ajharvie/TeensyPolySynth/README.md

A digital polysynth based on the teensy 4.1

Code heavily adapted from  Albert Nyström's 6-voice teensy synth: https://github.com/albnys/TeensyPoly6

I'll write up the new features and improvements at some point but I promise it's dead good
