ajharvie/TeensyPolySynth/boards/TeensySynth41.kicad_pcb

## KiCad design boards/TeensySynth41.kicad_pcb (2024-10-31)

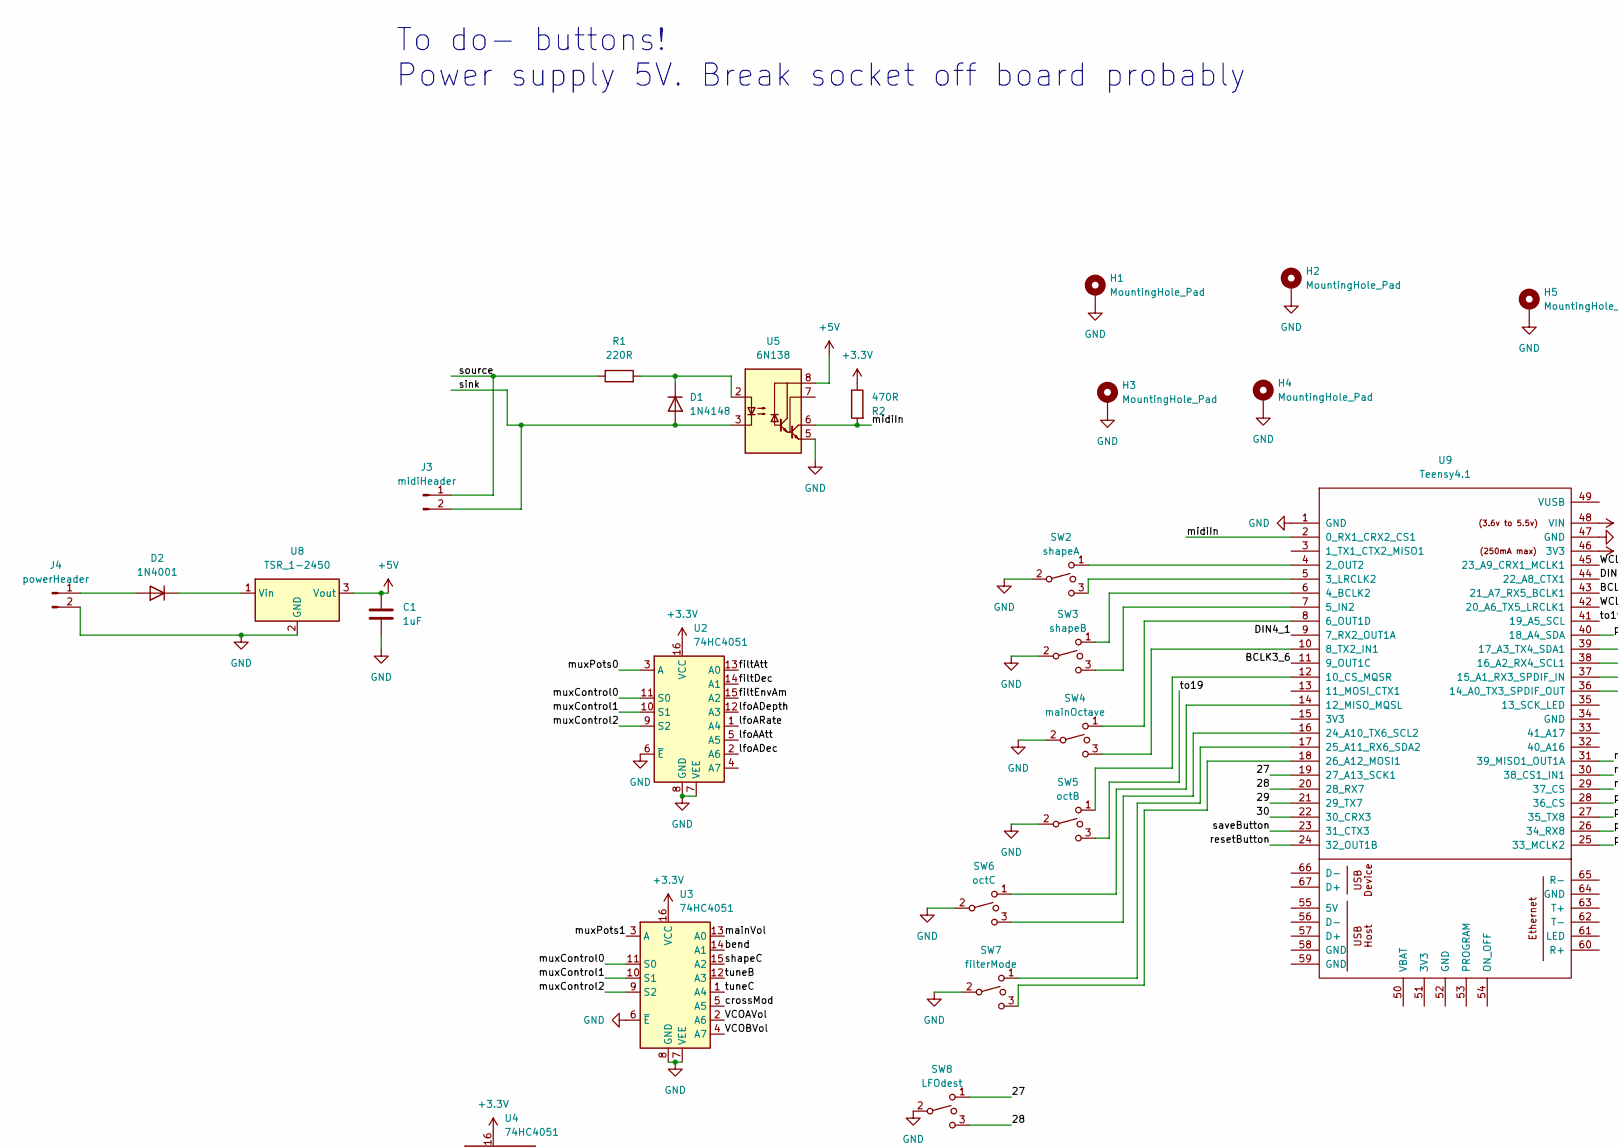
[picture p1: schematic TeensySynth41.kicad_sch, part in row 1, column 1]

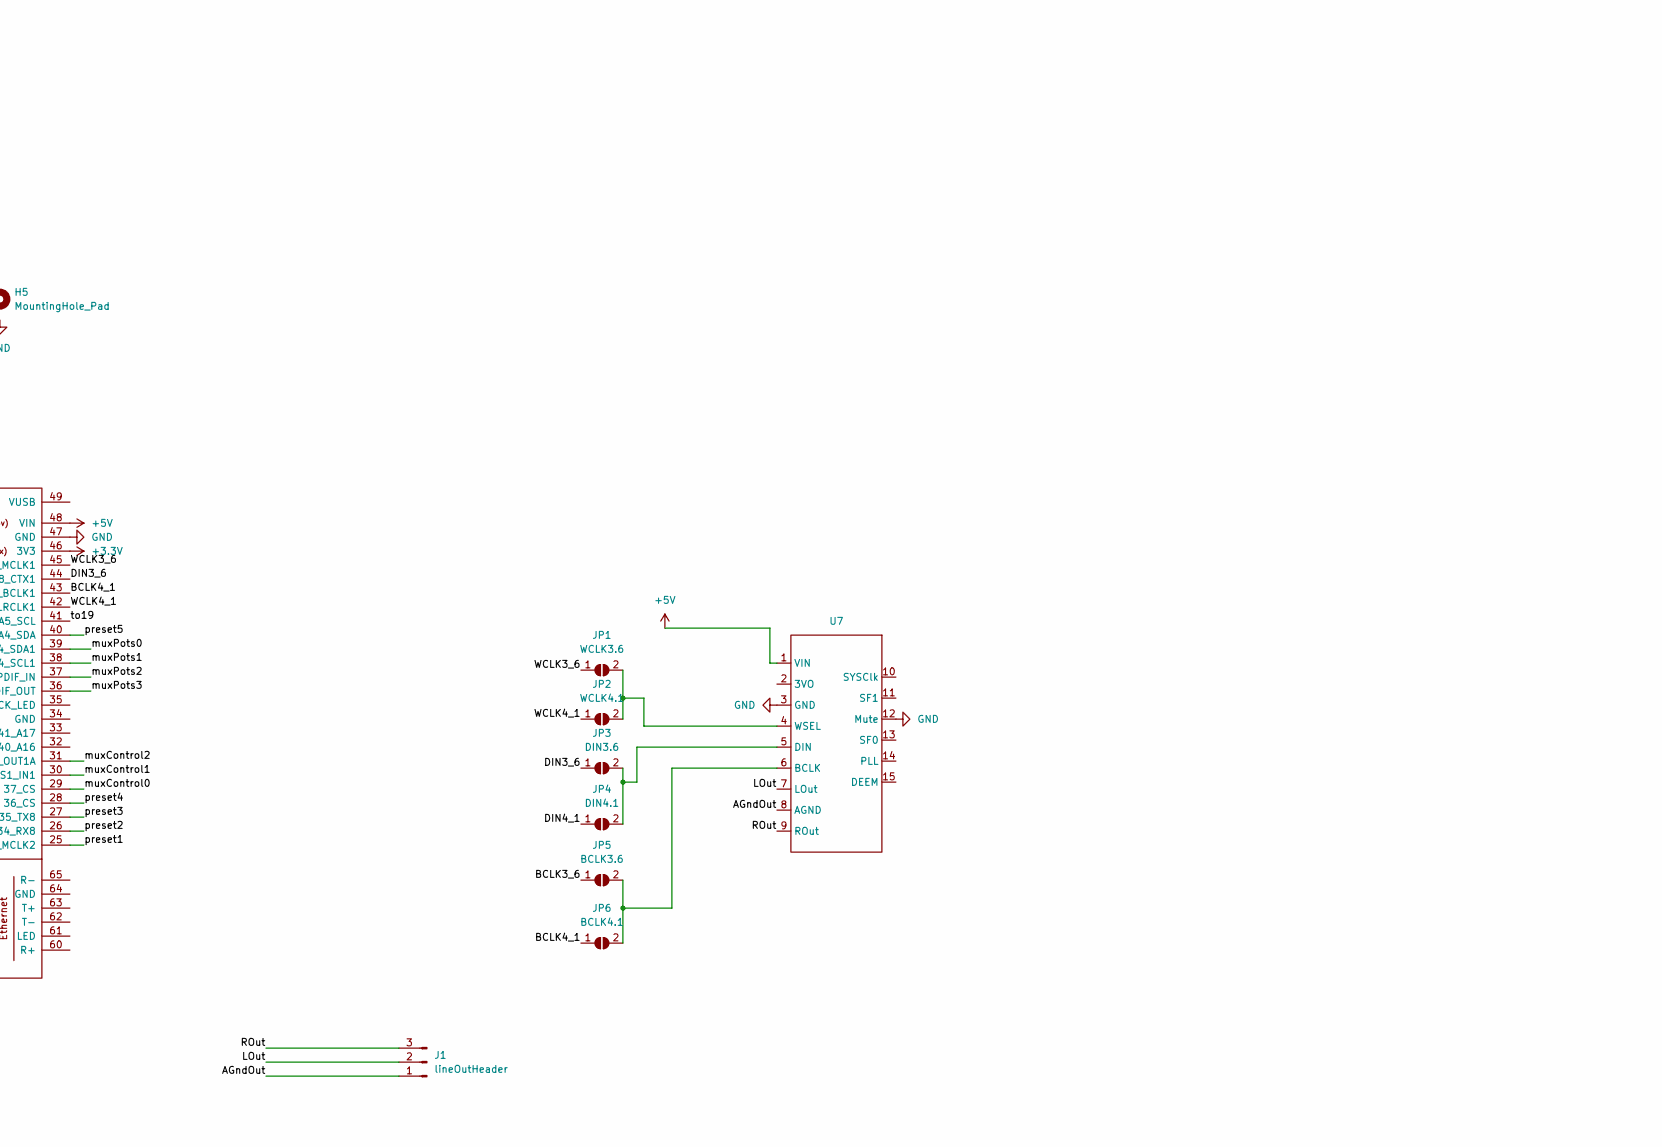
[picture p2: schematic TeensySynth41.kicad_sch, part in row 1, column 2]

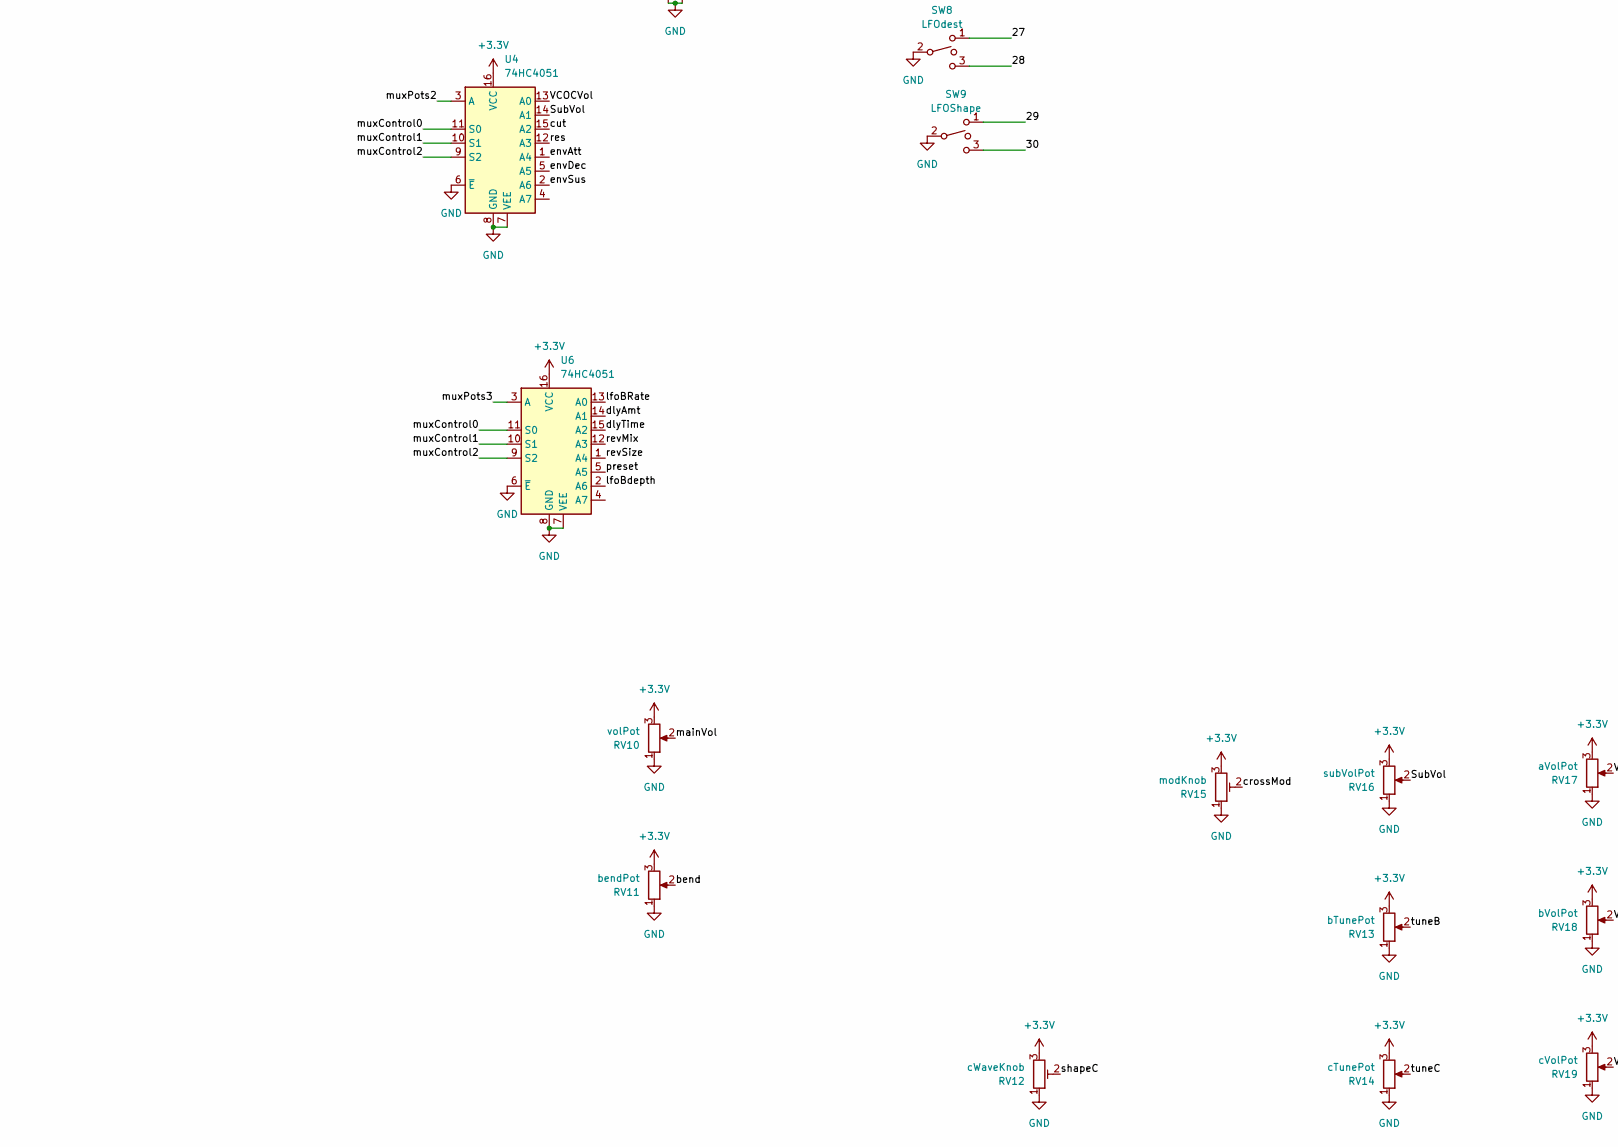
[picture p3: schematic TeensySynth41.kicad_sch, part in row 2, column 1]

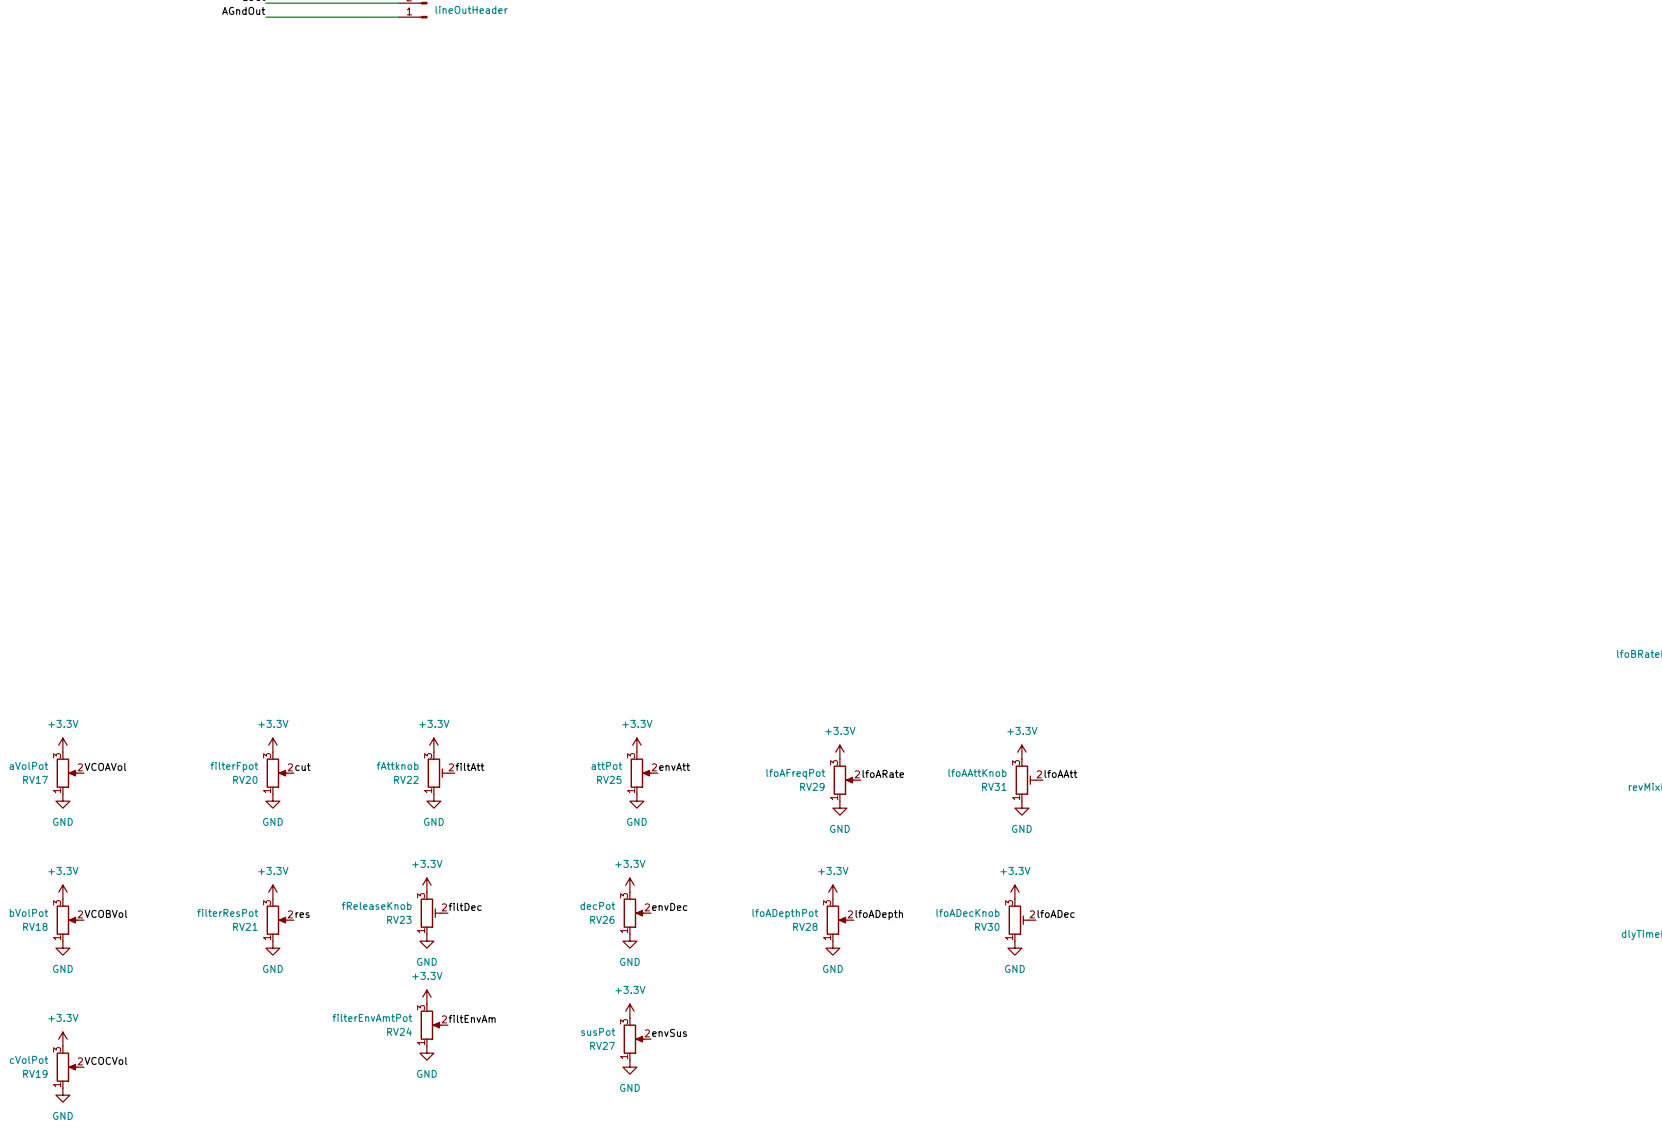
[picture p4: schematic TeensySynth41.kicad_sch, part in row 2, column 2]

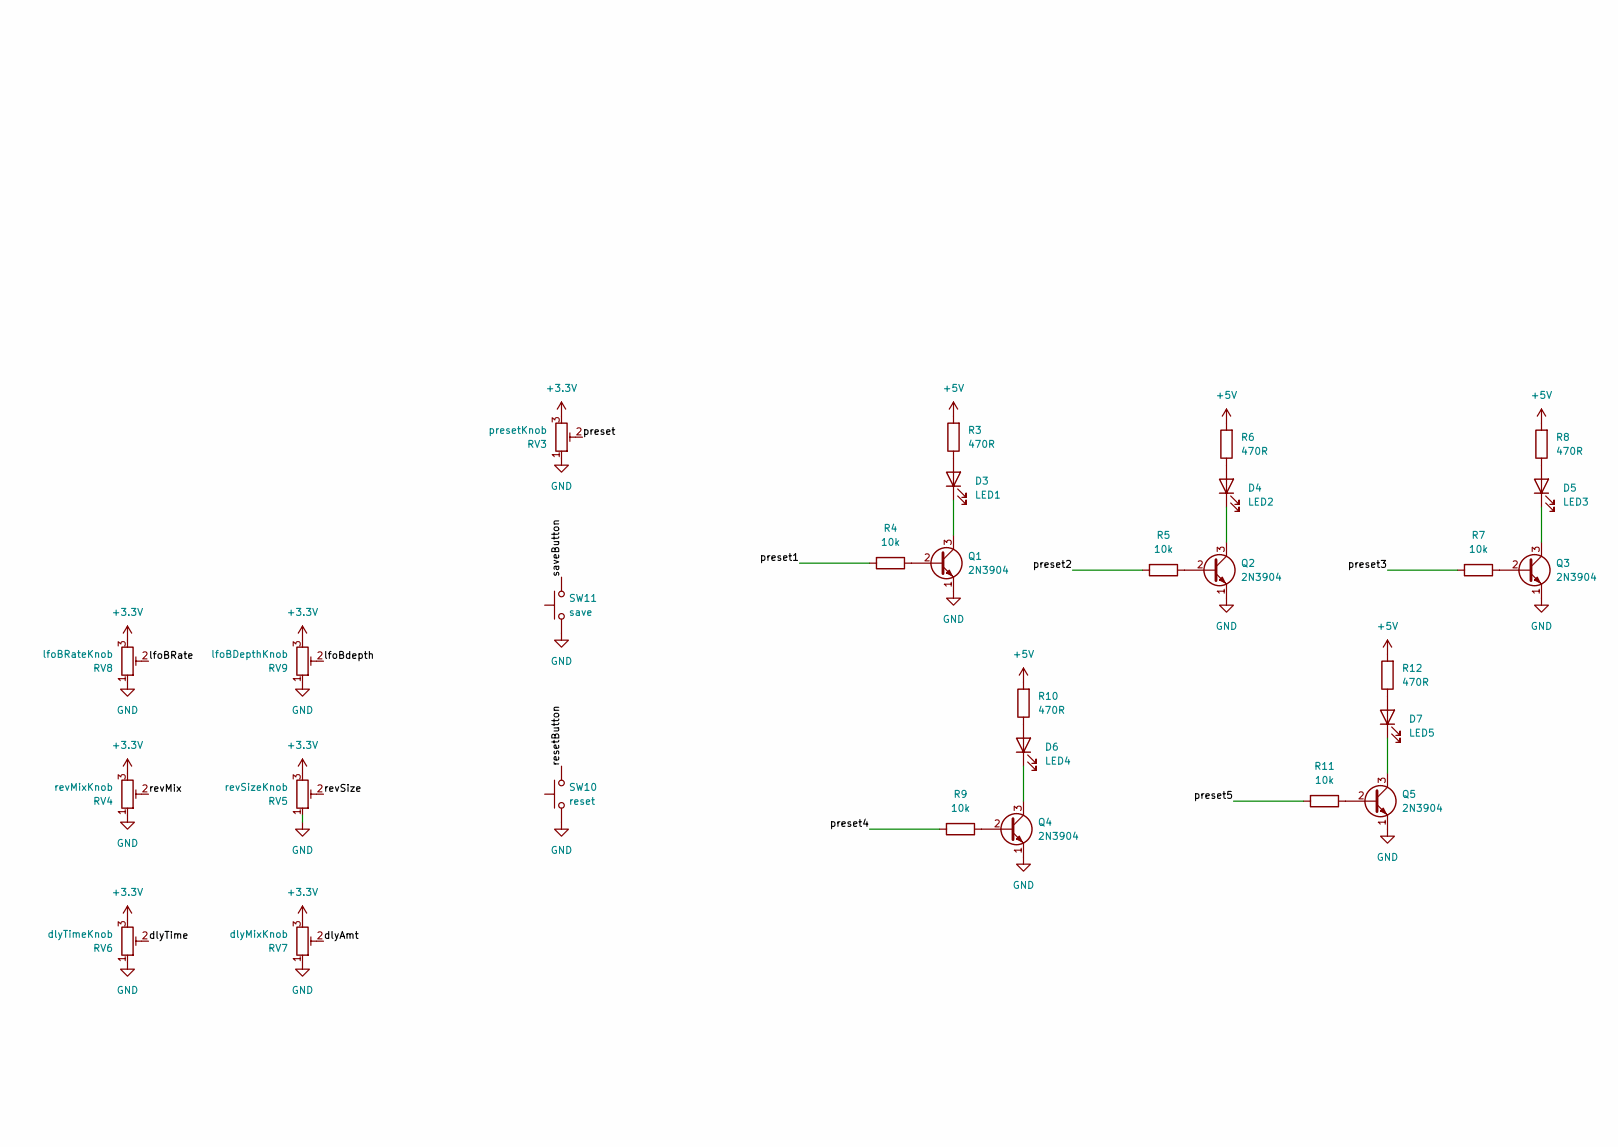
[picture p5: schematic TeensySynth41.kicad_sch, part in row 2, column 3]

Parts:
C1: 1uF; C_Disc_D7.0mm_W2.5mm_P5.00mm
D1: 1N4148; D_DO-35_SOD27_P7.62mm_Horizontal
D2: 1N4001; D_DO-41_SOD81_P10.16mm_Horizontal
D3: LED1; LED_D5.0mm_FlatTop
D4: LED2; LED_D5.0mm_FlatTop
D5: LED3; LED_D5.0mm_FlatTop
D6: LED4; LED_D5.0mm_FlatTop
D7: LED5; LED_D5.0mm_FlatTop
H1, H2, H3, H4, H5: MountingHole_Pad; MountingHole_3.2mm_M3_Pad
J1: lineOutHeader; TerminalBlock_Phoenix_MPT-0,5-3-2.54_1x03_P2.54mm_Horizontal
J3: midiHeader; TerminalBlock_Phoenix_MPT-0,5-2-2.54_1x02_P2.54mm_Horizontal
J4: powerHeader; TerminalBlock_Phoenix_MPT-0,5-2-2.54_1x02_P2.54mm_Horizontal
JP1: WCLK3.6; SolderJumper-2_P1.3mm_Open_Pad1.0x1.5mm
JP2: WCLK4.1; SolderJumper-2_P1.3mm_Open_Pad1.0x1.5mm
JP3: DIN3.6; SolderJumper-2_P1.3mm_Open_Pad1.0x1.5mm
JP4: DIN4.1; SolderJumper-2_P1.3mm_Open_Pad1.0x1.5mm
JP5: BCLK3.6; SolderJumper-2_P1.3mm_Open_Pad1.0x1.5mm
JP6: BCLK4.1; SolderJumper-2_P1.3mm_Open_Pad1.0x1.5mm
Q1, Q2, Q3, Q4, Q5: 2N3904; TO-92_Inline
R1: 220R; R_Axial_DIN0207_L6.3mm_D2.5mm_P7.62mm_Horizontal
R2, R3, R6, R8, R10, R12: 470R; R_Axial_DIN0207_L6.3mm_D2.5mm_P7.62mm_Horizontal
R4, R5, R7, R9, R11: 10k; R_Axial_DIN0207_L6.3mm_D2.5mm_P7.62mm_Horizontal
RV3: presetKnob; R0904N_newholes
RV4: revMixKnob; R0904N_newholes
RV5: revSizeKnob; R0904N_newholes
RV6: dlyTimeKnob; R0904N_newholes
RV7: dlyMixKnob; R0904N_newholes
RV8: lfoBRateKnob; R0904N_newholes
RV9: lfoBDepthKnob; R0904N_newholes
RV10: volPot; alphaPot_Centred
RV11: bendPot; alphaPot_Centred
RV12: cWaveKnob; R0904N_newholes
RV13: bTunePot; alphaPot_Centred
RV14: cTunePot; alphaPot_Centred
RV15: modKnob; R0904N_newholes
RV16: subVolPot; alphaPot_Centred
RV17: aVolPot; alphaPot_Centred
RV18: bVolPot; alphaPot_Centred
RV19: cVolPot; alphaPot_Centred
RV20: filterFpot; alphaPot_Centred
RV21: filterResPot; alphaPot_Centred
RV22: fAttknob; R0904N_newholes
RV23: fReleaseKnob; R0904N_newholes
RV24: filterEnvAmtPot; alphaPot_Centred
RV25: attPot; alphaPot_Centred
RV26: decPot; alphaPot_Centred
RV27: susPot; alphaPot_Centred
RV28: lfoADepthPot; alphaPot_Centred
RV29: lfoAFreqPot; alphaPot_Centred
RV30: lfoADecKnob; R0904N_newholes
RV31: lfoAAttKnob; R0904N_newholes
SW2: shapeA; miniToggle
SW3: shapeB; miniToggle
SW4: mainOctave; miniToggle
SW5: octB; miniToggle
SW6: octC; miniToggle
SW7: filterMode; miniToggle
SW8: LFOdest; miniToggle
SW9: LFOShape; miniToggle
SW10: reset; pushButtonEuro
SW11: save; pushButtonEuro
U2, U3, U4, U6: 74HC4051; DIP-16_W7.62mm
U5: 6N138; DIP-8_W7.62mm
U7: 1334ABreakout
U8: TSR_1-2450; Converter_DCDC_TRACO_TSR-1_THT
U9: Teensy4.1; Teensy41

Connections:
+3.3V: R2.1, RV3.3, RV4.3, RV5.3, RV6.3, RV7.3, RV8.3, RV9.3, RV10.3, RV11.3, RV12.3, RV13.3, RV14.3, RV15.3, RV16.3, RV17.3, RV18.3, RV19.3, RV20.3, RV21.3, RV22.3, RV23.3, RV24.3, RV25.3, RV26.3, RV27.3, RV28.3, RV29.3, RV30.3, RV31.3, U2.16 (VCC), U3.16 (VCC), U4.16 (VCC), U6.16 (VCC), U9.46 (3V3)
+5V: C1.1, R3.2, R6.2, R8.2, R10.2, R12.2, U5.8 (VCC), U7.1 (VIN), U8.3 (Vout), U9.48 (VIN)
/27: SW8.1, U9.19 (27_A13_SCK1)
/28: SW8.3, U9.20 (28_RX7)
/29: SW9.1, U9.21 (29_TX7)
/30: SW9.3, U9.22 (30_CRX3)
/AGndOut: J1.1, U7.8 (AGND)
/BCLK3_6: JP5.1 (A), U9.11 (9_OUT1C)
/BCLK4_1: JP6.1 (A), U9.43 (21_A7_RX5_BCLK1)
/DIN3_6: JP3.1 (A), U9.44 (22_A8_CTX1)
/DIN4_1: JP4.1 (A), U9.9 (7_RX2_OUT1A)
/LOut: J1.2, U7.7 (LOut)
/ROut: J1.3, U7.9 (ROut)
/SubVol: RV16.2, U4.14 (A1)
/VCOAVol: RV17.2, U3.2 (A6)
/VCOBVol: RV18.2, U3.4 (A7)
/VCOCVol: RV19.2, U4.13 (A0)
/WCLK3_6: JP1.1 (A), U9.45 (23_A9_CRX1_MCLK1)
/WCLK4_1: JP2.1 (A), U9.42 (20_A6_TX5_LRCLK1)
/bend: RV11.2, U3.14 (A1)
/crossMod: RV15.2, U3.5 (A5)
/cut: RV20.2, U4.15 (A2)
/dlyAmt: RV7.2, U6.14 (A1)
/dlyTime: RV6.2, U6.15 (A2)
/envAtt: RV25.2, U4.1 (A4)
/envDec: RV26.2, U4.5 (A5)
/envSus: RV27.2, U4.2 (A6)
/filtAtt: RV22.2, U2.13 (A0)
/filtDec: RV23.2, U2.14 (A1)
/filtEnvAm: RV24.2, U2.15 (A2)
/lfoAAtt: RV31.2, U2.5 (A5)
/lfoADec: RV30.2, U2.2 (A6)
/lfoADepth: RV28.2, U2.12 (A3)
/lfoARate: RV29.2, U2.1 (A4)
/lfoBRate: RV8.2, U6.13 (A0)
/lfoBdepth: RV9.2, U6.2 (A6)
/mainVol: RV10.2, U3.13 (A0)
/midiIn: R2.2, U5.6 (VO2), U9.2 (0_RX1_CRX2_CS1)
/muxControl0: U2.11 (S0), U3.11 (S0), U4.11 (S0), U6.11 (S0), U9.29 (37_CS)
/muxControl1: U2.10 (S1), U3.10 (S1), U4.10 (S1), U6.10 (S1), U9.30 (38_CS1_IN1)
/muxControl2: U2.9 (S2), U3.9 (S2), U4.9 (S2), U6.9 (S2), U9.31 (39_MISO1_OUT1A)
/muxPots0: U2.3 (A), U9.39 (17_A3_TX4_SDA1)
/muxPots1: U3.3 (A), U9.38 (16_A2_RX4_SCL1)
/muxPots2: U4.3 (A), U9.37 (15_A1_RX3_SPDIF_IN)
/muxPots3: U6.3 (A), U9.36 (14_A0_TX3_SPDIF_OUT)
/preset: RV3.2, U6.5 (A5)
/preset1: R4.2, U9.25 (33_MCLK2)
/preset2: R5.2, U9.26 (34_RX8)
/preset3: R7.2, U9.27 (35_TX8)
/preset4: R9.2, U9.28 (36_CS)
/preset5: R11.2, U9.40 (18_A4_SDA)
/res: RV21.2, U4.12 (A3)
/resetButton: SW10.2, U9.24 (32_OUT1B)
/revMix: RV4.2, U6.12 (A3)
/revSize: RV5.2, U6.1 (A4)
/saveButton: SW11.2, U9.23 (31_CTX3)
/shapeC: RV12.2, U3.15 (A2)
/sink: D1.2 (A), J3.2, U5.3 (C2)
/source: J3.1, R1.1
/to19: SW5.3, U9.41 (19_A5_SCL)
/tuneB: RV13.2, U3.12 (A3)
/tuneC: RV14.2, U3.1 (A4)
GND: C1.2, H1.1, H2.1, H3.1, H4.1, H5.1, J4.2, Q1.1 (E), Q2.1 (E), Q3.1 (E), Q4.1 (E), Q5.1 (E), RV3.1, RV4.1, RV5.1, RV6.1, RV7.1, RV8.1, RV9.1, RV10.1, RV11.1, RV12.1, RV13.1, RV14.1, RV15.1, RV16.1, RV17.1, RV18.1, RV19.1, RV20.1, RV21.1, RV22.1, RV23.1, RV24.1, RV25.1, RV26.1, RV27.1, RV28.1, RV29.1, RV30.1, RV31.1, SW2.2, SW3.2, SW4.2, SW5.2, SW6.2, SW7.2, SW8.2, SW9.2, SW10.1, SW11.1, U2.6 (~E), U2.7 (VEE), U2.8 (GND), U3.6 (~E), U3.7 (VEE), U3.8 (GND), U4.6 (~E), U4.7 (VEE), U4.8 (GND), U5.5 (GND), U6.6 (~E), U6.7 (VEE), U6.8 (GND), U7.3 (GND), U7.12 (Mute), U8.2 (GND), U9.1 (GND), U9.47 (GND)
unnamed: D1.1 (K), R1.2, U5.2 (C1)
unnamed: D2.2 (A), J4.1
unnamed: D2.1 (K), U8.1 (Vin)
unnamed: D3.2 (A), R3.1
unnamed: D3.1 (K), Q1.3 (C)
unnamed: D4.2 (A), R6.1
unnamed: D4.1 (K), Q2.3 (C)
unnamed: D5.2 (A), R8.1
unnamed: D5.1 (K), Q3.3 (C)
unnamed: D6.2 (A), R10.1
unnamed: D6.1 (K), Q4.3 (C)
unnamed: D7.2 (A), R12.1
unnamed: D7.1 (K), Q5.3 (C)
unnamed: JP1.2 (B), JP2.2 (B), U7.4 (WSEL)
unnamed: JP3.2 (B), JP4.2 (B), U7.5 (DIN)
unnamed: JP5.2 (B), JP6.2 (B), U7.6 (BCLK)
unnamed: Q1.2 (B), R4.1
unnamed: Q2.2 (B), R5.1
unnamed: Q3.2 (B), R7.1
unnamed: Q4.2 (B), R9.1
unnamed: Q5.2 (B), R11.1
unnamed: SW2.1, U9.4 (2_OUT2)
unnamed: SW2.3, U9.5 (3_LRCLK2)
unnamed: SW3.1, U9.6 (4_BCLK2)
unnamed: SW3.3, U9.7 (5_IN2)
unnamed: SW4.1, U9.8 (6_OUT1D)
unnamed: SW4.3, U9.10 (8_TX2_IN1)
unnamed: SW5.1, U9.12 (10_CS_MQSR)
unnamed: SW6.1, U9.14 (12_MISO_MQSL)
unnamed: SW6.3, U9.16 (24_A10_TX6_SCL2)
unnamed: SW7.1, U9.17 (25_A11_RX6_SDA2)
unnamed: SW7.3, U9.18 (26_A12_MOSI1)

Notes on the sheet:
To do- buttons! Power supply 5V. Break socket off board probably

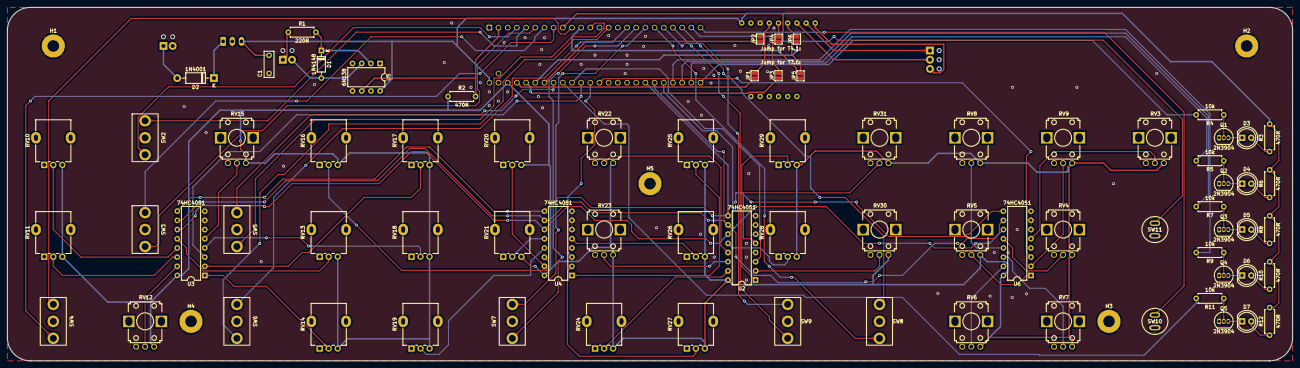
[picture p6: board TeensySynth41.kicad_pcb from above]

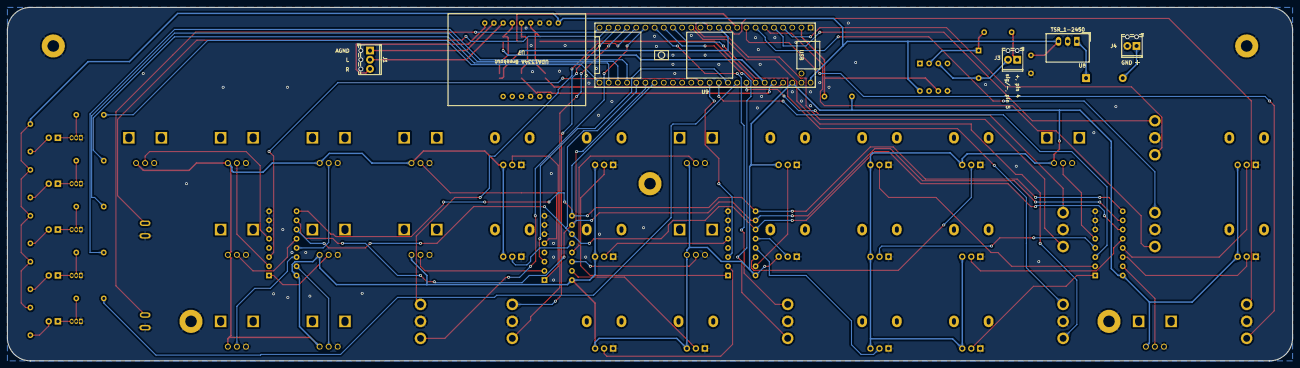
[picture p7: board TeensySynth41.kicad_pcb from below]

Board: 2 copper layers, 355.6 x 97.8 mm, 86 parts (6 on the bottom side), 95 nets.
