ajharvie/TeensyPolySynth/TeensyPolySynth/c_loop_vcos.ino

void loop() {
  
  if (debugTimer > 1000){
    debugTimer = 0;
    
    //Serial.println(rms1.read());
  }
  
  if (shout == 1){
    startPlaying();
  }
  else{
    stopPlaying();
  }

  MIDI.read();//read pitch bend
  MIDI.read();//why not two? as a treat

  if (voices < 0) {
    voices = 0;
  }
  

  //cross mod
  modMix1.gain(0, crossMod);
  modMix2.gain(0, crossMod);
  modMix3.gain(0, crossMod);
  modMix4.gain(0, crossMod);
  modMix5.gain(0, crossMod);
  modMix6.gain(0, crossMod);

  pitchFactorFiltered = 0.05*pitchFactor + 0.95*pitchFactorFiltered; //low pass the pitch bend input to make it smoother
  tuneBFiltered = 0.05*tuneB + 0.95*tuneBFiltered;
  tuneCFiltered = 0.05*tuneC + 0.95*tuneCFiltered;


  a1Freq = noteFreqs[note1freq] * octave * pitchFactorFiltered;
  b1Freq = noteFreqs[note1freq] * octave * octaveB * tuneBFiltered * pitchFactorFiltered;
  c1Freq = noteFreqs[note1freq] * octave * octaveC * tuneCFiltered * pitchFactorFiltered;
  sub1Freq = (noteFreqs[note1freq] / 2) * octave * pitchFactorFiltered;
  
  
  //exponential filtering for glide
  if (sinceLastFilter >= filterTime){
    sinceLastFilter = 0; //reset elapsedMicros
    if (polyMode == 0){
      a1FreqFiltered = glideVal*a1Freq + (1 - glideVal)*oldA1Freq;
      b1FreqFiltered = glideVal*b1Freq + (1 - glideVal)*oldB1Freq; 
      c1FreqFiltered = glideVal*c1Freq + (1 - glideVal)*oldC1Freq; 
      sub1FreqFiltered = glideVal*sub1Freq + (1 - glideVal)*oldSub1Freq;

      oldA1Freq = a1FreqFiltered;
      oldB1Freq = b1FreqFiltered;
      oldC1Freq = c1FreqFiltered;
      oldSub1Freq = sub1FreqFiltered;      
    }
  }


  
  if (polyMode == 0){ //mono (allows glide)
    vcoA1.frequency(a1FreqFiltered);
    vcoB1.frequency(b1FreqFiltered);
    vcoC1.frequency(c1FreqFiltered);
    sub1.frequency(sub1FreqFiltered);    
  }
  else{ //poly (no glide)
    vcoA1.frequency(a1Freq);
    vcoB1.frequency(b1Freq);
    vcoC1.frequency(c1Freq);
    sub1.frequency(sub1Freq);  
  }


  vcoA2.frequency(noteFreqs[note2freq] * octave * pitchFactorFiltered);
  b2Freq = noteFreqs[note2freq] * octave * octaveB * tuneBFiltered * pitchFactorFiltered; //separate because goes to LFO2 if needed
  vcoB2.frequency(b2Freq);
  c2Freq = noteFreqs[note2freq] * octave * octaveC * tuneCFiltered * pitchFactorFiltered;
  vcoC2.frequency(c2Freq);
  sub2.frequency(noteFreqs[note2freq] / 2 * octave * pitchFactorFiltered);

  vcoA3.frequency(noteFreqs[note3freq] * octave * pitchFactorFiltered);
  b3Freq = noteFreqs[note3freq] * octave * octaveB * tuneBFiltered * pitchFactorFiltered;
  vcoB3.frequency(b3Freq);
  c3Freq = noteFreqs[note3freq] * octave * octaveC * tuneCFiltered * pitchFactorFiltered;
  vcoC3.frequency(c3Freq);
  sub3.frequency(noteFreqs[note3freq] / 2 * octave * pitchFactorFiltered);

  vcoA4.frequency(noteFreqs[note4freq] * octave * pitchFactorFiltered);
  b4Freq = noteFreqs[note4freq] * octave * octaveB * tuneBFiltered * pitchFactorFiltered;
  vcoB4.frequency(b4Freq);
  c4Freq = noteFreqs[note4freq] * octave * octaveC * tuneCFiltered * pitchFactorFiltered;
  vcoC4.frequency(c4Freq);
  sub4.frequency(noteFreqs[note4freq] / 2 * octave * pitchFactorFiltered);

  vcoA5.frequency(noteFreqs[note5freq] * octave * pitchFactorFiltered);
  b5Freq = noteFreqs[note5freq] * octave * octaveB * tuneBFiltered * pitchFactorFiltered;
  vcoB5.frequency(b5Freq);
  c5Freq = noteFreqs[note5freq] * octave * octaveC * tuneCFiltered * pitchFactorFiltered;
  vcoC5.frequency(c5Freq);
  sub5.frequency(noteFreqs[note5freq] / 2 * octave * pitchFactorFiltered);

  vcoA6.frequency(noteFreqs[note6freq] * octave * pitchFactorFiltered);
  b6Freq = noteFreqs[note6freq] * octave * octaveB * tuneBFiltered * pitchFactorFiltered;
  vcoB6.frequency(b6Freq);
  c6Freq = noteFreqs[note6freq] * octave * octaveC * tuneCFiltered * pitchFactorFiltered;
  vcoC6.frequency(c6Freq);
  sub6.frequency(noteFreqs[note6freq] / 2 * octave * pitchFactorFiltered);



  //vco Mixer
  voiceMix1.gain(0, vcoAvol * mainVol);
  voiceMix1.gain(1, vcoBvol * mainVol);
  voiceMix1.gain(2, vcoCvol * mainVol);
  voiceMix1.gain(3, Subvol * mainVol);

  voiceMix2.gain(0, vcoAvol * mainVol);
  voiceMix2.gain(1, vcoBvol * mainVol);
  voiceMix2.gain(2, vcoCvol * mainVol);
  voiceMix2.gain(3, Subvol * mainVol);

  voiceMix3.gain(0, vcoAvol * mainVol);
  voiceMix3.gain(1, vcoBvol * mainVol);
  voiceMix3.gain(2, vcoCvol * mainVol);
  voiceMix3.gain(3, Subvol * mainVol);

  voiceMix4.gain(0, vcoAvol * mainVol);
  voiceMix4.gain(1, vcoBvol * mainVol);
  voiceMix4.gain(2, vcoCvol * mainVol);
  voiceMix4.gain(3, Subvol * mainVol);

  voiceMix5.gain(0, vcoAvol * mainVol);
  voiceMix5.gain(1, vcoBvol * mainVol);
  voiceMix5.gain(2, vcoCvol * mainVol);
  voiceMix5.gain(3, Subvol * mainVol);

  voiceMix6.gain(0, vcoAvol * mainVol);
  voiceMix6.gain(1, vcoBvol * mainVol);
  voiceMix6.gain(2, vcoCvol * mainVol);
  voiceMix6.gain(3, Subvol * mainVol);



  //vco A shape
  if (shapeA == 0) {
    vcoA1.begin(WAVEFORM_PULSE);
    vcoA2.begin(WAVEFORM_PULSE);
    vcoA3.begin(WAVEFORM_PULSE);
    vcoA4.begin(WAVEFORM_PULSE);
    vcoA5.begin(WAVEFORM_PULSE);
    vcoA6.begin(WAVEFORM_PULSE);
  } else if (shapeA == 1) {
    vcoA1.begin(WAVEFORM_SAWTOOTH);
    vcoA1.amplitude(vcoVol);
    vcoA2.begin(WAVEFORM_SAWTOOTH);
    vcoA2.amplitude(vcoVol);
    vcoA3.begin(WAVEFORM_SAWTOOTH);
    vcoA3.amplitude(vcoVol);
    vcoA4.begin(WAVEFORM_SAWTOOTH);
    vcoA4.amplitude(vcoVol);
    vcoA5.begin(WAVEFORM_SAWTOOTH);
    vcoA5.amplitude(vcoVol);
    vcoA6.begin(WAVEFORM_SAWTOOTH);
    vcoA6.amplitude(vcoVol);
  } else if (shapeA == 2) {
    vcoA1.begin(WAVEFORM_TRIANGLE_VARIABLE);
    vcoA1.amplitude(vcoVol * 1.5);
    vcoA2.begin(WAVEFORM_TRIANGLE_VARIABLE);
    vcoA2.amplitude(vcoVol * 1.5);
    vcoA3.begin(WAVEFORM_TRIANGLE_VARIABLE);
    vcoA3.amplitude(vcoVol * 1.5);
    vcoA4.begin(WAVEFORM_TRIANGLE_VARIABLE);
    vcoA4.amplitude(vcoVol * 1.5);
    vcoA5.begin(WAVEFORM_TRIANGLE_VARIABLE);
    vcoA5.amplitude(vcoVol * 1.5);
    vcoA6.begin(WAVEFORM_TRIANGLE_VARIABLE);
    vcoA6.amplitude(vcoVol * 1.5);
  }



  //vco B shape
  if (shapeB == 0) {
    vcoB1.offset(-0.006); //so that it doesn't tune the other wave
    vcoB2.offset(-0.006);
    vcoB3.offset(-0.006);
    vcoB4.offset(-0.006);
    vcoB5.offset(-0.006);
    vcoB6.offset(-0.006);
    vcoB1.begin(WAVEFORM_PULSE);
    vcoB2.begin(WAVEFORM_PULSE);
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
    vcoC6.arbitraryWaveform(wave100, 2000);
    vcoC1.amplitude(vcoVol * 1.50);
    vcoC2.amplitude(vcoVol * 1.50);
    vcoC3.amplitude(vcoVol * 1.50);
    vcoC4.amplitude(vcoVol * 1.50);
    vcoC5.amplitude(vcoVol * 1.50);
    vcoC6.amplitude(vcoVol * 1.50);
}
 
