ajharvie/TeensyPolySynth/TeensyPolySynth/a_globals.ino

//to do:
//double check output levels
// need 5 successive values above threshold to change (only for small thresholds) - cutoff, tuneb, tunec

//nice ideas:
//keyboard filter tracking?
//more voices?
//noise somehow? Perhaps use glide knob in poly mode?




#include <Audio.h>
#include <Wire.h>
#include <SPI.h>
#include <SD.h>
#include <SerialFlash.h>

#include "AudioSampleScreamattack.h"   
#include "AudioSampleScreamsustain.h" 
#include "AudioSampleScreamdecay.h" 

#include <Bounce.h>

const int saveButtonPin = 31;
Bounce saveButton = Bounce(saveButtonPin, 10);

// GUItool: begin automatically generated code
AudioSynthWaveform       lfoA1;          //xy=1268,2186
AudioSynthWaveform       lfoB1;          //xy=1461.5712985992432,1589.8571491241455
AudioEffectEnvelope      lfoAenv1;       //xy=1466.4285278320312,1649.2856845855713
AudioEffectEnvelope      lfoAenv3;       //xy=1465.4285125732422,2190.857105255127
AudioEffectEnvelope      lfoAenv2;       //xy=1474.8571166992188,1930.8571090698242
AudioEffectEnvelope      lfoAenv4;       //xy=1474,2448
AudioSynthWaveform       lfoB3;          //xy=1477.5714950561523,2138.428569793701
AudioEffectEnvelope      lfoAenv5;       //xy=1480,2698
AudioSynthWaveform       lfoB2;          //xy=1485.142936706543,1878.0001420974731
AudioEffectEnvelope      lfoAenv6;       //xy=1482,2968
AudioSynthWaveform       lfoB4;          //xy=1486.8570671081543,2389.5715980529785
AudioSynthWaveform       lfoB6;          //xy=1490.9998741149902,2907.857129096985
AudioSynthWaveform       lfoB5;          //xy=1493.0000305175781,2644.142812728882
AudioMixer4              modMix1;        //xy=1513.71431350708,1497.2857398986816
AudioMixer4              modMix2;        //xy=1514,1811
AudioMixer4              modMix3;        //xy=1516,2071
AudioMixer4              modMix4;        //xy=1516,2332
AudioMixer4              modMix5;        //xy=1522,2581
AudioMixer4              modMix6;        //xy=1524,2852
AudioSynthWaveformModulated sub1;           //xy=1663,1664
AudioSynthWaveformModulated vcoA1;          //xy=1664,1571
AudioSynthWaveformModulated vcoB1;          //xy=1664,1602
AudioSynthWaveformModulated vcoC1;          //xy=1664,1633
AudioSynthWaveformModulated sub2;           //xy=1669,1922
AudioSynthWaveformModulated vcoA2;          //xy=1670,1829
AudioSynthWaveformModulated vcoB2;          //xy=1670,1860
AudioSynthWaveformModulated vcoC2;          //xy=1670,1891
AudioSynthWaveformModulated sub3;           //xy=1671,2182
AudioSynthWaveformModulated vcoA3;          //xy=1672,2089
AudioSynthWaveformModulated vcoB3;          //xy=1672,2120
AudioSynthWaveformModulated vcoC3;          //xy=1672,2151
AudioSynthWaveformModulated sub4;           //xy=1671,2443
AudioSynthWaveformModulated vcoA4;          //xy=1672,2350
AudioSynthWaveformModulated vcoB4;          //xy=1672,2381
AudioSynthWaveformModulated vcoC4;          //xy=1672,2412
AudioSynthWaveformModulated sub5;           //xy=1677,2692
AudioSynthWaveformModulated vcoA5;          //xy=1678,2599
AudioSynthWaveformModulated vcoB5;          //xy=1678,2630
AudioSynthWaveformModulated vcoC5;          //xy=1678,2661
AudioSynthWaveformModulated sub6;           //xy=1679,2963
AudioSynthWaveformModulated vcoA6;          //xy=1680,2870
AudioSynthWaveformModulated vcoB6;          //xy=1680,2901
AudioSynthWaveformModulated vcoC6;          //xy=1680,2932
AudioMixer4              voiceMix1;      //xy=1825,1616
AudioMixer4              voiceMix2;      //xy=1831,1874
AudioMixer4              voiceMix3;      //xy=1833,2134
AudioMixer4              voiceMix4;      //xy=1833,2395
AudioMixer4              voiceMix5;      //xy=1839,2644
AudioMixer4              voiceMix6;      //xy=1841,2915
AudioSynthWaveformDc     dc1;            //xy=1847,1664
AudioSynthWaveformDc     dc2;            //xy=1853,1922
AudioSynthWaveformDc     dc3;            //xy=1855,2182
AudioSynthWaveformDc     dc4;            //xy=1855,2443
AudioSynthWaveformDc     dc5;            //xy=1861,2692
AudioSynthWaveformDc     dc6;            //xy=1863,2963
AudioEffectEnvelope      filterEnv1;     //xy=1966,1653
AudioEffectEnvelope      filterEnv2;     //xy=1972,1911
AudioEffectEnvelope      filterEnv3;     //xy=1974,2171
AudioEffectEnvelope      filterEnv4;     //xy=1974,2432
AudioEffectEnvelope      filterEnv5;     //xy=1980,2681
AudioEffectEnvelope      filterEnv6;     //xy=1982,2952
AudioMixer4              filterMix1;     //xy=2138,1655
AudioMixer4              filterMix2;     //xy=2144,1913
AudioMixer4              filterMix3;     //xy=2146,2173
AudioMixer4              filterMix4;     //xy=2146,2434
AudioMixer4              filterMix5;     //xy=2152,2683
AudioMixer4              filterMix6;     //xy=2154,2954
AudioFilterStateVariable filter1;        //xy=2259,1622
AudioFilterStateVariable filter2;        //xy=2265,1880
AudioFilterStateVariable filter3;        //xy=2267,2140
AudioFilterStateVariable filter4;        //xy=2267,2401
AudioFilterStateVariable filter5;        //xy=2273,2650
AudioFilterStateVariable filter6;        //xy=2275,2921
AudioMixer4              filterMode1;    //xy=2391,1637
AudioMixer4              filterMode2;    //xy=2397,1895
AudioMixer4              filterMode3;    //xy=2399,2155
AudioMixer4              filterMode4;    //xy=2399,2416
AudioMixer4              filterMode5;    //xy=2405,2665
AudioMixer4              filterMode6;    //xy=2407,2936
AudioEffectEnvelope      env1;           //xy=2521,1637
AudioSynthWaveformDc     dc9;            //xy=2522,2341
AudioEffectEnvelope      env2;           //xy=2527,1895
AudioEffectEnvelope      env3;           //xy=2529,2155
AudioEffectEnvelope      env4;           //xy=2529,2416
AudioEffectEnvelope      env5;           //xy=2534,2665
AudioEffectEnvelope      env6;           //xy=2537,2936
AudioSynthWaveformDc     dc8;            //xy=2564,2096
AudioSynthWaveformDc     dc10;           //xy=2572,2577
AudioSynthWaveformDc     dc7;            //xy=2579,1818
AudioSynthWaveformDc     dc11;           //xy=2596,2857
AudioSynthWaveformDc     dc12;           //xy=2601,3095
AudioEffectMultiply      multiply3;      //xy=2692,2290
AudioEffectMultiply      multiply4;      //xy=2725,2533
AudioEffectMultiply      multiply1;      //xy=2735,1768
AudioEffectMultiply      multiply2;      //xy=2738,2057
AudioEffectMultiply      multiply5;      //xy=2736,2801
AudioEffectMultiply      multiply6;      //xy=2781,3047
AudioMixer4              mix1;           //xy=2863,2241
AudioMixer4              mix2;           //xy=2863,2373
AudioFilterStateVariable dlyFiltL;       //xy=2953,2459
AudioFilterStateVariable dlyFiltR;       //xy=2957,2790
AudioPlayMemory          playMem3;       //xy=2967,1959
AudioPlayMemory          playMem4;       //xy=2967,2018
AudioPlayMemory          playMem2;       //xy=2968,1897
AudioPlayMemory          playMem1;       //xy=2970,1837
AudioMixer4              finalMix;       //xy=2988,2310
AudioMixer4              shoutMixer;     //xy=3207,1924
AudioAmplifier           amp3;           //xy=3210,2124
AudioEffectDelay         dlyR;           //xy=3320,2730
AudioEffectDelay         dlyL;           //xy=3321,2496
AudioMixer4              dlyMixR;        //xy=3321,2630
AudioMixer4              dlyMixL;        //xy=3332,2392
AudioEffectFreeverbStereo reverb;         //xy=3368,2111
AudioMixer4              fxL;            //xy=3572,2241
AudioMixer4              fxR;            //xy=3572,2363
AudioAmplifier           amp2;           //xy=3743,2343
AudioAmplifier           amp1;           //xy=3746,2219
AudioOutputI2S           i2s1;           //xy=3961,2289
AudioConnection          patchCord1(lfoA1, lfoAenv1);
AudioConnection          patchCord2(lfoA1, lfoAenv2);
AudioConnection          patchCord3(lfoA1, lfoAenv3);
AudioConnection          patchCord4(lfoA1, lfoAenv4);
AudioConnection          patchCord5(lfoA1, lfoAenv5);
AudioConnection          patchCord6(lfoA1, lfoAenv6);
AudioConnection          patchCord7(lfoAenv1, 0, modMix1, 1);
AudioConnection          patchCord8(lfoAenv1, 0, vcoB1, 0);
AudioConnection          patchCord9(lfoAenv1, 0, vcoC1, 0);
AudioConnection          patchCord10(lfoAenv1, 0, sub1, 0);
AudioConnection          patchCord11(lfoAenv1, 0, filterMix1, 1);
AudioConnection          patchCord12(lfoAenv1, 0, multiply1, 1);
AudioConnection          patchCord165(lfoAenv2, 0, multiply2, 1);
AudioConnection          patchCord166(lfoAenv3, 0, multiply3, 1);
AudioConnection          patchCord167(lfoAenv4, 0, multiply4, 1);
AudioConnection          patchCord168(lfoAenv5, 0, multiply5, 1);
AudioConnection          patchCord169(lfoAenv6, 0, multiply6, 1);
AudioConnection          patchCord170(dc7, 0, multiply1, 1);
AudioConnection          patchCord171(dc8, 0, multiply2, 1);
AudioConnection          patchCord172(dc9, 0, multiply3, 1);
AudioConnection          patchCord173(dc10, 0, multiply4, 1);
AudioConnection          patchCord174(dc11, 0, multiply5, 1);
AudioConnection          patchCord175(dc12, 0, multiply6, 1);
AudioConnection          patchCord13(lfoB1, 0, vcoA1, 1);
AudioConnection          patchCord14(lfoB1, 0, vcoB1, 1);
AudioConnection          patchCord15(lfoAenv2, 0, modMix2, 1);
AudioConnection          patchCord16(lfoAenv2, 0, vcoB2, 0);
AudioConnection          patchCord17(lfoAenv2, 0, vcoC2, 0);
AudioConnection          patchCord18(lfoAenv2, 0, sub2, 0);
AudioConnection          patchCord19(lfoAenv2, 0, filterMix2, 1);
AudioConnection          patchCord20(lfoAenv3, 0, modMix3, 1);
AudioConnection          patchCord21(lfoAenv3, 0, vcoB3, 0);
AudioConnection          patchCord22(lfoAenv3, 0, vcoC3, 0);
AudioConnection          patchCord23(lfoAenv3, 0, sub3, 0);
AudioConnection          patchCord24(lfoAenv3, 0, filterMix3, 1);
AudioConnection          patchCord25(lfoAenv4, 0, modMix4, 1);
AudioConnection          patchCord26(lfoAenv4, 0, vcoB4, 0);
AudioConnection          patchCord27(lfoAenv4, 0, vcoC4, 0);
AudioConnection          patchCord28(lfoAenv4, 0, sub4, 0);
AudioConnection          patchCord29(lfoAenv4, 0, filterMix4, 1);
AudioConnection          patchCord30(lfoB2, 0, vcoA2, 1);
AudioConnection          patchCord31(lfoB2, 0, vcoB2, 1);
AudioConnection          patchCord32(lfoB3, 0, vcoA3, 1);
AudioConnection          patchCord33(lfoB3, 0, vcoB3, 1);
AudioConnection          patchCord34(lfoB4, 0, vcoA4, 1);
AudioConnection          patchCord35(lfoB4, 0, vcoB4, 1);
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
AudioConnection          patchCord147(dlyFiltR, 0, dlyMixR, 1);
AudioConnection          patchCord148(dlyFiltL, 0, dlyMixL, 1);
AudioConnection          patchCord149(dlyR, 0, dlyFiltR, 0);
AudioConnection          patchCord150(dlyL, 0, dlyFiltL, 0);
AudioConnection          patchCord151(dlyMixR, 0, fxR, 2);
AudioConnection          patchCord152(dlyMixR, dlyR);
AudioConnection          patchCord153(dlyMixL, 0, fxL, 2);
AudioConnection          patchCord154(dlyMixL, dlyL);
AudioConnection          patchCord155(reverb, 0, fxL, 1);
AudioConnection          patchCord156(reverb, 1, fxR, 1);
AudioConnection          patchCord157(fxL, 0, amp1, 0);
AudioConnection          patchCord158(fxR, 0, amp2, 0);
AudioConnection          patchCord178(amp1, 0, i2s1, 0);
AudioConnection          patchCord179(amp2, 0, i2s1, 1);
AudioConnection          patchCord180(playMem1, 0, shoutMixer, 0);
AudioConnection          patchCord181(playMem2, 0, shoutMixer, 1);
AudioConnection          patchCord182(playMem3, 0, shoutMixer, 2);
AudioConnection          patchCord183(playMem4, 0, shoutMixer, 3);
AudioConnection          patchCord184(shoutMixer, 0, finalMix, 2); 
AudioConnection          patchCord185(finalMix, 0, amp3, 0); 
AudioConnection          patchCord186(amp3, 0, reverb, 0); 



#include <MIDI.h>
#include <EEPROMex.h>


MIDI_CREATE_INSTANCE(HardwareSerial, Serial1, MIDI);


elapsedMillis debugTimer;

//////// Multiplexer //////////////////////////////////////////////////////////////////////////////////////
///////////////////////////////////////////////////////////////////////////////////////////////////////////
const int muxPots0 = A3;
const int muxPots1 = A2;
const int muxPots2 = A1;
const int muxPots3 = A0;

float wait = 100; //mux read delay (micros)

//mux chip 0
int mux0_0;
int mux1_0;
int mux2_0;
int mux3_0;
int mux4_0;
int mux5_0;
int mux6_0;
int mux7_0;

//mux chip 1
int mux0_1;
int mux1_1;
int mux2_1;
int mux3_1;
int mux4_1;
int mux5_1;
int mux6_1;
int mux7_1;

//mux chip 2
int mux0_2;
int mux1_2;
int mux2_2;
int mux3_2;
int mux4_2;
int mux5_2;
int mux6_2;
int mux7_2;

//mux chip 3
int mux0_3;
int mux1_3;
int mux2_3;
int mux3_3;
int mux4_3;
int mux5_3;
int mux6_3;
int mux7_3;

int silent;
unsigned int delayFix = 3;
int shout = 0;


///// notes, frequencies, voices /////////////////////////////////////////////////////////////////////////
///////////////////////////////////////////////////////////////////////////////////////////////////////////
const float noteFreqs[128] = {8.176, 8.662, 9.177, 9.723, 10.301, 10.913, 11.562, 12.25, 12.978, 13.75, 14.568, 15.434, 16.352, 17.324, 18.354, 19.445, 20.602, 21.827, 23.125, 24.5, 25.957, 27.5, 29.135, 30.868, 32.703, 34.648, 36.708, 38.891, 41.203, 43.654, 46.249, 48.999, 51.913, 55, 58.27, 61.735, 65.406, 69.296, 73.416, 77.782, 82.407, 87.307, 92.499, 97.999, 103.826, 110, 116.541, 123.471, 130.813, 138.591, 146.832, 155.563, 164.814, 174.614, 184.997, 195.998, 207.652, 220, 233.082, 246.942, 261.626, 277.183, 293.665, 311.127, 329.628, 349.228, 369.994, 391.995, 415.305, 440, 466.164, 493.883, 523.251, 554.365, 587.33, 622.254, 659.255, 698.456, 739.989, 783.991, 830.609, 880, 932.328, 987.767, 1046.502, 1108.731, 1174.659, 1244.508, 1318.51, 1396.913, 1479.978, 1567.982, 1661.219, 1760, 1864.655, 1975.533, 2093.005, 2217.461, 2349.318, 2489.016, 2637.02, 2793.826, 2959.955, 3135.963, 3322.438, 3520, 3729.31, 3951.066, 4186.009, 4434.922, 4698.636, 4978.032, 5274.041, 5587.652, 5919.911, 6271.927, 6644.875, 7040, 7458.62, 7902.133, 8372.018, 8869.844, 9397.273, 9956.063, 10548.08, 11175.3, 11839.82, 12543.85};

int note1freq;
int note2freq;
int note3freq;
int note4freq;
int note5freq;
int note6freq;

int voices;

//polyphony/glide

int polyMode;
int polyModesw;
int oldPolyModesw;
float glideVal;
float oldA1Freq;
float oldB1Freq;
float oldC1Freq;
float oldSub1Freq;
int glidePot;
int oldGlidePot;

//osc 1 frequencies for portamento purposes
float a1Freq;
float c1Freq;
float sub1Freq;
float a1FreqFiltered;
float b1FreqFiltered;
float c1FreqFiltered;
float sub1FreqFiltered;
//b frequencies (not needed nowadays but whatever)
float b1Freq;
float b2Freq;
float b3Freq;
float b4Freq;
float b5Freq;
float b6Freq;

//C frequencies for modulation purposes. lfo 2 matches oscC frequency when turned all the way up, for pwm fun
float c2Freq;
float c3Freq;
float c4Freq;
float c5Freq;
float c6Freq;

//glide smoothing parameters
unsigned int filterTime = 5000;
elapsedMicros sinceLastFilter;






//checks if notes are on or not
///////////////////////////////////////////////////////////////////////////////////////////////////////////
bool env1on = false;
bool env2on = false;
bool env3on = false;
bool env4on = false;
bool env5on = false;
bool env6on = false;

//int vol of vcos.
float vcoVol = 0.07;
float mainVol;


//real bending
float numSemitones;
float pitchFactor = 1;
float pitchFactorFiltered = 1;


//voice mixer
///////////////////////////////////////////////////////////////////////////////////////////////////////////
float vcoAvol = 0.5;
float vcoBvol = 0.5;
float vcoCvol = 0.5;
float Subvol = 0.5;

float crossMod;

//Tunings, octaves etc.
///////////////////////////////////////////////////////////////////////////////////////////////////////////
float octave = 1;
float octaveB = 1;
float octaveC = 1;
float tuneB = 1;
float tuneC = 1;
float tuneBFiltered = 1;
float tuneCFiltered = 1;

//vco shapes
int shapeA;
int shapeB;
int shapeC = 1;
int waveSelect;


//filter
///////////////////////////////////////////////////////////////////////////////////////////////////////////
int cut = 2000;
float res = 1;
int filtAtt;
int filtDec;
float filtAmt;

int filterMode;
float filterExtMod;


//envelope
///////////////////////////////////////////////////////////////////////////////////////////////////////////
int envAtt;
int envDec;
int envRel;
float envSus;

const float minTime = 5; //minimum length of any bit of adsr. prevents pops

//lfo A
///////////////////////////////////////////////////////////////////////////////////////////////////////////
float lfoAamp;
float lfoAampMin;
float lfoAfreq;
const float lfoAMaxFreq = 200.0;
int lfoAdel = 1; //weird overflow happens
int lfoAatt;
int lfoAdec = 1;
int lfoArel;
float lfoAsus = 1;

int lfoAshape;
int lfoAdest;


//tremolo
float ampMod;
float readInt = 1.0001;
unsigned long prevTime;


//lfo B
///////////////////////////////////////////////////////////////////////////////////////////////////////////
float lfoBamp;
float lfoBfreq;
const float lfoBMaxFreq = 50.0;
byte lfoBSnap = 0; // 1 if frequency matches that of oscillator C. 0 if not. Turn freq knob fully rightwards to set to C
byte lfoBSnapsw; // "switch" parlance to match how it works in the other ones. pointless really not sure why i did it lmao
byte oldlfoBSnapsw;
const int lfoBSnapKnobThresh = 1010; //knob position that's considered "fully rightwards" will have to adjust to see
int justSnapped = 1;



//delay
///////////////////////////////////////////////////////////////////////////////////////////////////////////
float outGain = 0.8;
float dlyAmt;

float dlyTimeL;
float dlyTimeR;

//reverb
///////////////////////////////////////////////////////////////////////////////////////////////////////////
float revMix;
float revSize;




//Presets
///////////////////////////////////////////////////////////////////////////////////////////////////////////
int preset;
int resetting = 1;

bool prevBtn1;
bool prevBtn2;
bool prevBtn3;
bool prevBtn4;
bool prevBtn5;

bool presetLoaded1 = 0;
bool presetLoaded2 = 0;
bool presetLoaded3 = 0;
bool presetLoaded4 = 0;
bool presetLoaded5 = 0;




//turncheck
///////////////////////////////////////////////////////////////////////////////////////////////////////////
int resetPressed = 1;
int savePressed = 1;

float tresh = 10;
float tresh2 = 20;
float tresh3 = 4;

int cutCount = 0;
int tuneBCount = 0;
int tuneCCount = 0;
int shapeCCount = 0;
int threshCounts = 2; //counts until new value is accepted
float tresh4 = 8; //no longer used
bool firstBoot = true;

unsigned int timer = 6; //6 ms between changing settings - needs testing
elapsedMillis sinceMeasure;


int tuneBpot;
int oldTuneBpot;
int tuneCpot;
int oldTuneCpot;

float octBsw;
float oldOctBsw;
float octCsw;
float oldOctCsw;

int shapeAsw;
int oldShapeAsw;
int shapeBsw;
int oldShapeBsw;
int shapeCpot;
int oldShapeCpot;


int crossModpot;
int oldCrossModpot;

int volApot;
int oldVolApot;
int volBpot;
int oldVolBpot;
int volCpot;
int oldVolCpot;
int volSubpot;
int oldVolSubpot;

int cutpot;
int oldCutpot;
int respot;
int oldRespot;

int filtModesw;
int oldFiltModesw;

int fAttpot;
int oldFAttpot;
int fDecpot;
int oldFDecpot;
int fAmtpot;
int oldFAmtpot;


int attpot;
int oldAttpot;
int decpot;
int oldDecpot;
float suspot;
float oldSuspot;

int lfoAmppot;
int oldLfoAmppot;
int lfoFreqpot;
int oldLfoFreqpot;
int lfoAttpot;
int oldLfoAttpot;
int lfoDecpot;
int oldLfoDecpot;
int lfoSuspot;
int oldLfoSuspot;

int lfoShapesw;
int oldLfoShapesw;
int lfoDestsw;
int oldLfoDestsw;

int lfoBAmppot;
int oldLfoBAmppot;
int lfoBFreqpot;
int oldLfoBFreqpot;

int dlyAmtpot;
int oldDlyAmtpot;
int dlyTimepot;
int oldDlyTimepot;

int revMixpot;
int oldRevMixpot;
int revSizepot;
int oldRevSizepot;



//lookup table for exponentialifying pots and that
const float expLookup1024[] = {
  0,  0.01, 0.01, 0.02, 0.03, 0.04, 0.04, 0.05,
  0.06, 0.06, 0.07, 0.08, 0.09, 0.09, 0.1,
  0.11, 0.12, 0.12, 0.13, 0.14, 0.15, 0.15,
  0.16, 0.17, 0.18, 0.19, 0.19, 0.2,  0.21,
  0.22, 0.23, 0.23, 0.24, 0.25, 0.26, 0.27,
  0.28, 0.29, 0.29, 0.3,  0.31, 0.32, 0.33,
  0.34, 0.35, 0.36, 0.37, 0.38, 0.39, 0.4,
  0.4,  0.41, 0.42, 0.43, 0.44, 0.45, 0.46,
  0.47, 0.48, 0.49, 0.5,  0.51, 0.52, 0.53,
  0.54, 0.55, 0.57, 0.58, 0.59, 0.6,  0.61,
  0.62, 0.63, 0.64, 0.65, 0.66, 0.68, 0.69,
  0.7,  0.71, 0.72, 0.73, 0.74, 0.76, 0.77,
  0.78, 0.79, 0.8,  0.82, 0.83, 0.84, 0.85,
  0.87, 0.88, 0.89, 0.91, 0.92, 0.93, 0.94,
  0.96, 0.97, 0.98, 1,  1.01, 1.02, 1.04,
  1.05, 1.07, 1.08, 1.09, 1.11, 1.12, 1.14,
  1.15, 1.17, 1.18, 1.2,  1.21, 1.23, 1.24,
  1.26, 1.27, 1.29, 1.3,  1.32, 1.33, 1.35,
  1.37, 1.38, 1.4,  1.41, 1.43, 1.45, 1.46,
  1.48, 1.5,  1.52, 1.53, 1.55, 1.57, 1.58,
  1.6,  1.62, 1.64, 1.66, 1.67, 1.69, 1.71,
  1.73, 1.75, 1.77, 1.78, 1.8,  1.82, 1.84,
  1.86, 1.88, 1.9,  1.92, 1.94, 1.96, 1.98,
  2,  2.02, 2.04, 2.06, 2.08, 2.1,  2.12,
  2.15, 2.17, 2.19, 2.21, 2.23, 2.25, 2.28,
  2.3,  2.32, 2.34, 2.37, 2.39, 2.41, 2.43,
  2.46, 2.48, 2.51, 2.53, 2.55, 2.58, 2.6,
  2.63, 2.65, 2.68, 2.7,  2.73, 2.75, 2.78,
  2.8,  2.83, 2.85, 2.88, 2.91, 2.93, 2.96,
  2.99, 3.01, 3.04, 3.07, 3.1,  3.12, 3.15,
  3.18, 3.21, 3.24, 3.27, 3.3,  3.32, 3.35,
  3.38, 3.41, 3.44, 3.47, 3.5,  3.53, 3.57,
  3.6,  3.63, 3.66, 3.69, 3.72, 3.75, 3.79,
  3.82, 3.85, 3.89, 3.92, 3.95, 3.99, 4.02,
  4.05, 4.09, 4.12, 4.16, 4.19, 4.23, 4.26,
  4.3,  4.34, 4.37, 4.41, 4.44, 4.48, 4.52,
  4.56, 4.59, 4.63, 4.67, 4.71, 4.75, 4.79,
  4.83, 4.87, 4.91, 4.95, 4.99, 5.03, 5.07,
  5.11, 5.15, 5.19, 5.23, 5.28, 5.32, 5.36,
  5.41, 5.45, 5.49, 5.54, 5.58, 5.63, 5.67,
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
};

// ONE HUNDRED WAVEFORMS, EACH WAVIER THAN THE LAST

const int16_t wave1[257] = {
0,  906,  1106, 1407, 1634, 1909, 2148, 2411, 2657, 2912, 3162, 3415, 3666, 3916, 4168, 4416, 4669, 4916, 5171, 5418, 
5672, 5920, 6175, 6423, 6676, 6924, 7178, 7426, 7680, 7929, 8182, 8432, 8684, 8934, 9185, 9436, 9687, 9938, 10189, 
10440, 10690, 10941, 11191, 11443, 11692, 11945, 12194, 12446, 12696, 12947, 13198, 13449, 13702, 13950, 14204, 14451,
 14706, 14952, 15209, 15452, 15712, 15953, 16215, 16455, 16719, 16955, 17219, 17457, 17720, 17961, 18220, 18466, 18719,
 18971, 19214, 19479, 19708, 19989, 20202, 20501, 20694, 21012, 21185, 21524, 21677, 22033, 22172, 22541, 22671, 23043,
 23175, 23540, 23685, 24028, 24205, 24509, 24732, 24980, 25269, 25440, 25814, 25895, 26368, 26342, 26924, 26786, 27483,
 27233, 28039, 27684, 28583, 28150, 29115, 28634, 29622, 29146, 30097, 29698, 30522, 30302, 30880, 30993, 31120, 31844,
 31114, 32767, 30248, 32767, -13140, -32767, -29141, -32768, -30050, -32768, -30128, -31941, -29980, -31147, -29734,
 -30425, -29431, -29747, -29084, -29108, -28702, -28500, -28291, -27922, -27853, -27369, -27392, -26837, -26910, -26326,
 -26410, -25829, -25898, -25342, -25379, -24864, -24852, -24388, -24323, -23913, -23795, -23439, -23268, -22959, -22744,
 -22476, -22227, -21989, -21714, -21497, -21203, -21000, -20699, -20500, -20197, -19998, -19696, -19494, -19199, -18987,
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
 -30556, -30354, -30515, -30331, -30474, -30330, -30433, -30358, -30391, -30372, -30232, -30330, -30005, -30290, -29682, -30249, -29140,
 -30207, -27821, -30167, 0};
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
