ajharvie/TeensyPolySynth/TeensyPolySynth/AudioSampleScreamattack.cpp

// Audio data converted from WAV file by wav2sketch

#include "AudioSampleScreamattack.h"

// Converted from screamAttack.wav, using 44100 Hz, u-law encoding
const unsigned int AudioSampleScreamattack[3425] = {
0x01003546,0x0D070403,0x0C0C0D0E,0x0E0D0B0B,0x090A0B0C,0x0D0E0D0A,0x07080909,0x0A0E100A,
0x06050708,0x80030708,0x82848281,0x8E898201,0x94939291,0x9F9D9A96,0xA2A1A1A0,0xA8A6A4A3,
0xA6A7A7A8,0xA6A6A5A5,0xA3A4A5A6,0xA1A2A3A3,0x858E959D,0x0D0D0E05,0x1D1B1813,0x1E1E1E1D,
0x21212120,0x1F202122,0x21222221,0x1F1F2022,0x1D1C1D1E,0x1A1A1C1C,0x15181A1A,0x83050C11,
0x93908A88,0x97979695,0x96969697,0x95979797,0x92929293,0x81889092,0x13110D07,0x17151413,
0x12151718,0x18171512,0x1B1D1C19,0x1D1D1B1A,0x1B1B1B1D,0x1818191B,0x1214181A,0x0A0D1011,
0x88810306,0x9A989691,0xA4A3A09D,0xA9A8A7A6,0xAFADACAA,0xB3B3B2B1,0xB6B6B5B4,0xB4B5B5B5,
0xB0B1B2B3,0x8294A2AB,0x2119130B,0x27282724,0x26222325,0x3031302C,0x2B2C2C2D,0x23272B2C,
0x28232121,0x282B2D2C,0x26252526,0x1E212425,0x0210161B,0xAAA59C90,0xB0B0AFAE,0xB1B0B0B0,
0xB4B3B2B2,0xB0B3B4B4,0x0594A1A9,0x23211D15,0x26262625,0x2C2A2726,0x2D2F2F2E,0x2323262A,
0x24242524,0x26262424,0x25252626,0x2C292625,0x292C2D2D,0x161E2326,0x96948A09,0xA09D9997,
0xAAA9A6A3,0xB0AFADAB,0xB1B1B1B1,0xB4B3B2B1,0xB3B4B4B4,0xB5B5B4B3,0xB7B7B6B5,0xB7B7B7B7,
0xA5B0B4B6,0x21160C91,0x322E2926,0x30303233,0x37323030,0x33343739,0x32323232,0x1F21272F,
0x28241F1D,0x18182025,0x1D201E1A,0x080F1017,0xA2978D81,0xB4B3B1AB,0xB4B3B3B4,0xB4B4B4B4,
0xB7B6B5B4,0xADB2B4B6,0x80919CA5,0x2720170F,0x3633312D,0x3A3A3A38,0x36383A3A,0x34343334,
0x35363534,0x252A2F32,0x1B212122,0x19171313,0x0C171818,0x99969389,0xA19B9B9B,0xACAAA8A6,
0xB1B0B0AE,0xADAEB0B2,0xAFADACAD,0xB6B6B5B2,0xB7B7B7B7,0xB7B6B6B7,0xBAB9B9B9,0xB4B7BABB,
0x1795A6B0,0x33322D25,0x39393734,0x36353738,0x39393736,0x2A2E3236,0x25282929,0x1311141D,
0x1A1D1F1A,0x190E0510,0x20222321,0x820A131B,0xB2ABA295,0xB6B6B6B5,0xB7B6B5B5,0xB7B8B8B8,
0xB3B5B6B7,0x8E9EA8B0,0x241E1608,0x3733312B,0x403E3C39,0x3D3E3F40,0x38383A3C,0x32343638,
0x282D3132,0x13121721,0x14141617,0x12111416,0x89081314,0x85878B8F,0xA29E958A,0xACABA8A5,
0xB2B2B0AE,0xB5B3B2B2,0xBDBBB9B7,0xBEBEBFBF,0xC0BFBFBF,0xBEBFC0C0,0xB4B7BABC,0x2501A6B1,
0x3433312D,0x3B3A3735,0x3638393B,0x3E3D3735,0x2E313439,0x2D2F2E2C,0x22212327,0x2D302B26,
0x23201F26,0x1F272A27,0x9A8C0614,0xB7B2ABA4,0xBCBDBDBB,0xBEBDBCBB,0xBBBEBFBF,0xB2B6B8BA,
0x0F94A4AD,0x3029241E,0x3D3B3935,0x41403F3F,0x3B3C3F41,0x37353538,0x33353839,0x32323233,
0x22242830,0x2B282523,0x1A1F262C,0x02101519,0xA2A19A8D,0xAAA7A5A2,0xB3B3B2AF,0xB3B2B1B1,
0xB9B7B5B4,0xC1BFBDBB,0xC0C1C1C1,0xC2C2C1BE,0xC2C3C2C2,0xB6B9BDC0,0x322496AF,0x39363534,
0x4040403D,0x3E404040,0x4042413E,0x32303339,0x292F3333,0x20222325,0x1B252521,0x2921140F,
0x1220292D,0xA9A09382,0xBEBBB6B1,0xBFBFC0C0,0xC3C2C1C0,0xBEC0C1C2,0xAFB4B8BC,0x281A8EA3,
0x3E3A3531,0x45454341,0x43444545,0x40414242,0x393B3D3F,0x33363739,0x2324292F,0x1D212324,
0x2021211F,0x131D2121,0x96948C05,0xAEA7A098,0xB2B1B0B0,0xB5B5B3B3,0xBCB9B7B6,0xC4C2C1BE,
0xC5C4C4C4,0xC6C6C6C5,0xC5C4C4C5,0xB6BDC1C3,0x322299AD,0x403E3834,0x42434342,0x43434343,
0x41434342,0x3233363D,0x272D3031,0x26262625,0x23272626,0x2B241B1B,0x16232A2D,0xA99B8C03,
0xC1BEB9B2,0xC3C2C2C2,0xC7C6C5C3,0xC2C4C5C7,0xACB5BCC1,0x342B149C,0x41403E3A,0x47464543,
0x48484848,0x43444547,0x3A3B4042,0x31343638,0x26282A2E,0x221F2124,0x24252726,0x171F2426,
0x99948B0C,0xADABA6A0,0xB7B4B1AD,0xC1BFBCB9,0xC7C7C6C3,0xC9C9C9C8,0xCDCCCCCB,0xC8C8C9CB,
0xBFC4C8C9,0x2495B0B7,0x433E3833,0x47484947,0x47464545,0x45454547,0x3D404244,0x2731363A,
0x2A282422,0x27222328,0x25242629,0x21242527,0x9F83131B,0xC3C0B7AE,0xC7C6C5C4,0xC8C8C7C7,
0xC6C7C8C8,0xBAC0C4C5,0x268DAAB4,0x433F3833,0x4C4B4947,0x504F4E4C,0x494A4C4E,0x42434548,
0x35393F41,0x29303032,0x0683091D,0x1B130E10,0x11161A1C,0x97810C0E,0xA7A6A7A3,0xBEB8B3AE,
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
};
