ajharvie/TeensyPolySynth/TeensyPolySynth/AudioSampleScreamdecay.cpp

// Audio data converted from WAV file by wav2sketch

#include "AudioSampleScreamdecay.h"

// Converted from screamDecay.wav, using 44100 Hz, u-law encoding
const unsigned int AudioSampleScreamdecay[3969] = {
0x01003DB8,0xD3D9DEE0,0xC5C7CDCF,0xD7D6D5CA,0xE3E3E2DC,0xE2E3E4E5,0xE5E3E3E4,0xD3DCE1E4,
0x655D4CA3,0x70706E6B,0x70707070,0x686A6D6F,0x41566065,0xEFE7DDC4,0xF7F6F4F3,0xF6F8F8F8,
0xDAE4ECF2,0x62594AC0,0x7674716A,0x77777979,0x73747576,0x5862686E,0xE0CF0F4B,0xFBF9F5ED,
0xEBF1F6FB,0xC1D2D9E3,0x4E433521,0x5C595453,0x575E605D,0xA1344751,0xD9D3C9BC,0xECEAE6E0,
0xE9EDF0F0,0x11D4E1E5,0x6E686356,0x70717171,0x66696C6F,0x68696868,0xC6415864,0xF3EFE8DE,
0xFBFBF9F6,0xF3F6F9FB,0xD0DBE5EF,0x736C5D00,0x79797977,0x7B7C7C7B,0x73737679,0x646C7072,
0xF8EFDA43,0xFBFBFBFB,0xF4F7FBFB,0xDDE7EEF1,0xBBC3CDD4,0x655E5230,0x7373716D,0x6C6F7073,
0x4C596166,0xE6E0D311,0xF4F3F2EE,0xEAF1F4F5,0x5037BCDC,0x6663605A,0x6A696A69,0x71716F6D,
0x52626A70,0xE5DFD2A3,0xF4F3F0EA,0xF0F2F4F4,0xDBE3E7EB,0x5A41C4D5,0x6F706E65,0x6A6C6E6E,
0x67676668,0x696E6C68,0xD5AB5864,0xDEE2E2DE,0xD2D5D6D7,0xD8D2D1D2,0xE2E1DFDC,0xDFE3E3E2,
0xD7DADBDA,0xCBD4D7D6,0x4121ACC3,0x48494B4B,0xCDC0973B,0x09B5C4CD,0x67625D4B,0x7170706D,
0x676D7071,0x525A6062,0xE0CC1C45,0xF1EEEAE6,0xF5F4F3F2,0xEDF0F3F5,0xBAD1E1E9,0x69614E1C,
0x72737270,0x6A6C6F71,0x5F616366,0x5D5E5D5B,0xC3314A57,0xCFD7DAD6,0xAEBAC2C5,0xCECBC0AD,
0xE6E1D7D2,0xEEEEECE8,0xEDEDEDED,0xE0E5E9EC,0x28BDD2DA,0x6C635746,0x74737371,0x70707173,
0x60686E70,0xC3134D59,0xEBE5DED0,0xF1F1F1F0,0xF0F1F0F0,0xCBE0E7EC,0x5F564924,0x6F6A6563,
0x70717170,0x646A6F70,0xB6215460,0xE0D7CCBE,0xF0EFE9E4,0xDAE1E5ED,0x482F8AC2,0x5F5C5650,
0x5C605F5D,0x3D4E565B,0xD3CBC19B,0xE5E2E0DD,0xEEECEBE8,0xE4E7EBEE,0x4B9FD2E0,0x6B69645B,
0x6E6D6C6C,0x6F6E6C6D,0x5C656A6D,0xE4DEC943,0xF2F0EDE9,0xF2F4F5F4,0xE2EAEEF0,0x573CC1D7,
0x71706A62,0x71717272,0x676B6E70,0x62616164,0xA0526063,0xECEBE6D8,0xE0E4E6E9,0xC7CCD4DA,
0xD7D6D3CB,0xD6D8D6D7,0xAABBC5CF,0xC6C2B6A1,0x9BB7B9C3,0x2C3F3C26,0xDBD0B78B,0xC9D6DBDE,
0x524228B0,0x6463615B,0x68696866,0x67696968,0x495D6365,0xE5E0D5B6,0xF4F2EEE9,0xF2F4F5F6,
0xE1E7EDF0,0x6046C4D6,0x76747068,0x75767676,0x626B7173,0x3C424F55,0xE4D69645,0xF0F3F3EF,
0xCFDAE2EA,0x504D40A7,0x54535452,0x4C535757,0xD5C79042,0xEAE7E3E0,0xEDECECEB,0xEAECEFEE,
0xCEDDE6E9,0x6E655719,0x78777572,0x75777878,0x676B7073,0xBF415460,0xEFEAE2D6,0xF6F4F3F1,
0xF5F8F9F8,0xDBE6EDF2,0x5A3FA5C5,0x72706B65,0x6E707072,0x676B6B6C,0x65666766,0x535E6365,
0xDDDBC93E,0xC7D0D5D8,0xDED6D1C9,0xE9E9E5E2,0xEFECEAE9,0xEBECECEF,0xD6DEE3E7,0x4129BFD1,
0x5F5C564D,0x706B6763,0x70707070,0x686B7070,0x37445563,0xDBD2C48F,0xEEEBE8E4,0xEFEDEDEE,
0xEFF1F1F0,0x9ECBDEE9,0x5C565142,0x72716D66,0x70707273,0x65696D70,0xBDA23859,0xD0C5C9C8,
0xE6E6E1D9,0xBAD3DFE2,0x423E14A9,0x54555248,0xC5A44250,0xE1DCD5D0,0xE7E6E4E4,0xE8E9E9E8,
0xD5E1E4E6,0x5B4B31BB,0x6E6A6562,0x6E6F7070,0x68696A6C,0x525D6266,0xDDD6C236,0xF3EFE7E2,
0xF4F7F7F6,0xE0E5EBF1,0xACCED8DC,0x6C665E48,0x7372706F,0x6B707374,0x6D696868,0x666E7170,
0xE5E0CC51,0xEEEAE8E7,0xEEF0F0F0,0xE8E8EBED,0xE0E2E4E6,0x1EBDD0D9,0x67625A49,0x696A6A69,
0x5E606367,0xB145545B,0xF2EDE3D5,0xF1F2F3F3,0x32CCE2EB,0x66626054,0x6F6C6A69,0x6F6F6E6E,
0x5C63686B,0xD5C43250,0xF1EDE6DD,0xF5F6F6F4,0xE3EAF1F3,0xA5CFDCE0,0x6E69604A,0x6C6D7070,
0x6568696B,0x65636161,0x55616A6B,0xDBE0D141,0xBBD1D7D6,0xCECAC4B6,0xD9D7D2CF,0xDCDBDAD9,
0xE3E1E0DF,0xDBDBDEE1,0xD7DAD9DA,0x99C1CCD1,0x00303B34,0xD1CEC0AE,0x2ABBC7CC,0x6E665B4E,
0x78777572,0x72767777,0x5C63686E,0xDFC9274E,0xF6F3F0E9,0xFBFAF9F8,0xF5F9FBFB,0xDDE6EEF2,
0x665520CE,0x74747370,0x74727173,0x6E717273,0x6C6C6C6C,0x545F676D,0xD2D4CD26,0xCEC7CBCD,
0xECE6E2D9,0xF5F4F3F1,0xF4F5F6F6,0xF0F0F0F2,0xDBE5EBED,0x6C6347C8,0x7C7B7873,0x7A7C7C7C,
0x6C717477,0x82536066,0xF3F0E5D5,0xF9F8F6F5,0xF7F9F9F9,0xE0EAF1F4,0x65532AC8,0x7A777370,
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
};
