ajharvie/TeensyPolySynth/TeensyPolySynth/AudioSampleScreamsustain.cpp

// Audio data converted from WAV file by wav2sketch

#include "AudioSampleScreamsustain.h"

// Converted from screamSustain.wav, using 44100 Hz, u-law encoding
const unsigned int AudioSampleScreamsustain[9473] = {
0x010093D0,0x32A6C9DB,0x56555951,0x60595759,0x65646261,0x72716E69,0x60666E72,0xCA254251,
0xEEE7E1DA,0xEFEFF0F0,0xEAEBEDEE,0xC7D8E2E7,0x48423A13,0x615B534D,0x62646463,0x63646563,
0x51545A61,0x4E43424B,0x5F605851,0x15445358,0xDBD4C7B1,0xE4E3E2DF,0xE5E3E3E4,0xE2E4E3E4,
0xD5DCDFE0,0xD6D1D2D2,0xDBDCDCDB,0x36C4D9DE,0x6B6B685A,0x6564686C,0x6A696967,0x6E6D6B6A,
0x455D656C,0xE2DFDAC7,0xF1EEEBE8,0xF0F3F3F3,0xDAE1E5EA,0x562EC1D1,0x706E6A64,0x706F7071,
0x6A6B6D70,0x525C6266,0xE7DFC140,0xEFEEEEEB,0xEBEAEBEE,0xE3E4E3E7,0xC9D4DBE0,0x575122BF,
0x6362625E,0x63626364,0x575B5D60,0xD3A8354B,0xE2E3E3E0,0x99C2D5DE,0x3921B1A5,0x3846423C,
0xBBBEB203,0xB9BEBDB5,0xD3D1D1C9,0xD6D5D3D4,0xC5D6DAD8,0x655C5031,0x72706F6B,0x74757574,
0x5D687073,0xD7CBA248,0xEBE8E6E0,0xF2F1F0EE,0xF1F2F2F2,0xDBE2E9EE,0x4E41ADD0,0x61615D56,
0x5A606362,0xC02F3F51,0xCCD3D9D7,0x544D3EB0,0x635E5D5C,0x69696866,0x62666969,0xC037515C,
0xE8E2DCD2,0xF3F2F1EE,0xF3F5F6F5,0xEBF0F1F2,0xCFDAE2E7,0x625542AF,0x7976726B,0x78787979,
0x76787A79,0x646B7174,0xCE94485B,0xEEE9E2D9,0xF6F6F4F1,0xF6F7F7F7,0xE1E9F0F4,0x488EC4D5,
0x65656258,0x65676665,0x5E636565,0xCA954053,0xF2EFE7DD,0xE4EAF1F3,0x5E50B7D8,0x73706862,
0x74777775,0x64676F71,0xD0A04960,0xF3F1ECE1,0xF9F8F7F5,0xF5F7F9F9,0xDEE8F1F3,0x6B6044C9,
0x7A787571,0x777A7B7A,0x6F717375,0x5660666B,0xE1D8C044,0xEAEAE8E4,0xE6E8EAEA,0xE0E3E3E3,
0xD2D7DADD,0x3E31B4C8,0x4E4F4A43,0x514F4D4D,0x323C4B50,0xE2D5C8A0,0xF2F0ECE9,0xDEE8EEF1,
0x605648BA,0x68656362,0x7572716D,0x74757677,0x53626A71,0xE7DCD0A7,0xF6F3F1EE,0xF5F6F7F7,
0xE3EAF0F3,0x573FC7D9,0x6E6E6A61,0x6C6B6D6E,0x6B6C6C6E,0x4A5A6469,0xE3DFD011,0xE4E7E6E3,
0xCCD3D9E0,0x223018B8,0x41381D90,0x5658554C,0x1B3E4A52,0xC2C2C0B4,0xCDC4B9C1,0xDCD9D3D0,
0xE1E1E1E0,0xECE8E6E5,0xE4ECEEED,0x5D5504D7,0x6262605A,0x706F6D65,0x75747373,0x6A707475,
0x02314D60,0xEDE6DCCA,0xF6F6F4F2,0xE9EDF2F4,0xB5D5E0E5,0x65625944,0x63636566,0x6B6B6966,
0x6164666A,0xD6A94B58,0xEAE8E5E1,0xE3E7E9EA,0xD2D8DCE0,0x4824BAC9,0x65635D53,0x61646465,
0x3E485058,0xCEB81830,0xF0E8E1D8,0xFBFAF7F4,0xE6F1F8FB,0x57513ED2,0x706A6460,0x79787774,
0x7A7A7A7A,0x69717578,0xC833515F,0xF2EEE9E1,0xF9FAF9F6,0xF2F4F7F8,0xBEDAE6EE,0x5D58503C,
0x6B676360,0x7171716E,0x696F7171,0xCA325762,0xDEE0DBD4,0xDADFE1E0,0xD9DAD9D8,0xCDD6D6D8,
0x3A31A0BB,0xC4B9A217,0xC7BFBCC2,0xEAE1D4CD,0xF2F4F2F0,0x3CCADAE8,0x5D535154,0x74716B64,
0x76767575,0x70737576,0x3A546168,0xE8E0CDA2,0xF8F7F3EE,0xEFF2F4F6,0xE1E7E9EC,0x5B5129CE,
0x64646360,0x6E706E68,0x686D6E6D,0x37525E63,0xDED6D2C3,0xDFDEE1E1,0xDEDDDEDD,0xD2D9DFE0,
0x3F22BBCD,0x3E444B49,0xABB0A034,0xD6D1C7B3,0xEEEBE7E0,0xDAE6F0F1,0x51533AC9,0x64605E56,
0x71716F6B,0x72737272,0x63686D71,0xC717475A,0xF1ECE6DC,0xF0F2F3F3,0xE8EAEBEE,0xC1D5E0E5,
0x5F554B35,0x6D696462,0x6F6F6F6E,0x666A6D6F,0xC921515F,0xE2E1D8D4,0xE2E1E1E1,0xE6E6E6E3,
0xDCE2E4E5,0xA2BBC8D4,0x37342C13,0xCA961C21,0xDEE1E1DB,0x4639B4D1,0x4F494B49,0x68655F55,
0x706E6C6A,0x696F7071,0x344F5A62,0xE7E2D5C1,0xF4F4F2EE,0xEBEFF1F2,0xD0DCE3E6,0x4B483CAE,
0x5C555351,0x67666462,0x60616265,0x5A60605E,0x5154585A,0x5E5C5754,0x2E50595C,0xE3DCD4C4,
0xEAE9E9E6,0xE9EAEDEC,0xE2E6E8E9,0xCFD4DADF,0xCBB9B5C6,0xD1D1D4D2,0x615526CA,0x666A6C68,
0x605F6366,0x66646161,0x66696867,0x9F4A5D63,0xE3DAD3CA,0xF2F0EFEA,0xE9EFF2F3,0xCCD8E0E4,
0x5D5241A1,0x6B6C6862,0x706D6C6A,0x6C6E7071,0x114A5966,0xEAE7E0D0,0xEEF0EFEC,0xE6E8EAEC,
0xD8DEE2E3,0x4914C6D3,0x67656156,0x67696D6A,0x5C616466,0xA3455458,0xE5DDD0C3,0xF0F0EDE9,
0xF1F2F4F3,0xD9E4EEF1,0x4827B0C8,0x6B655D54,0x7473716F,0x70727474,0x6264686E,0x2C515A60,
0xE7E2DBCC,0xE7EAEBEA,0xE2E3E3E4,0xCAD1D8DE,0xC3C1C4C9,0x4A3AA9C1,0x59595752,0x555A5B58,
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
};
